janelia-experimental-technology/ElectricalPenetrationGraph/docs/model/preview.png

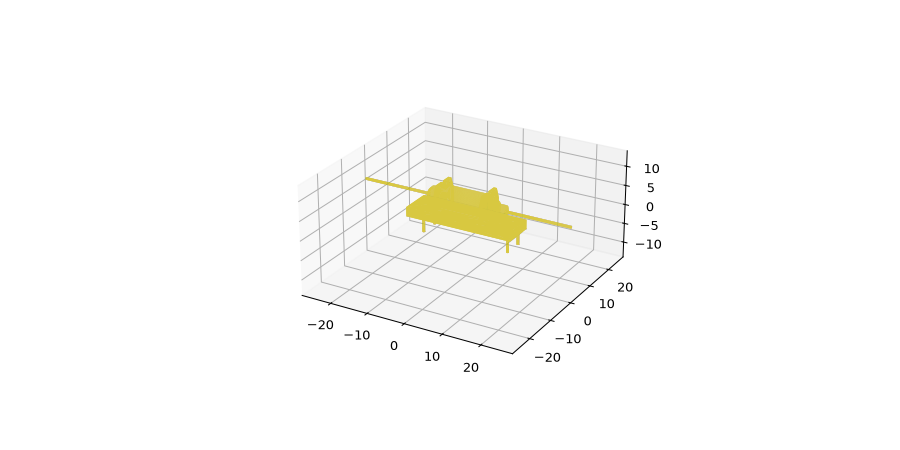
docs/model/preview.png
