janelia-experimental-technology/ElectricalPenetrationGraph/hardware/pcb/eagle/EPGcontrol.csv

Partlist exported from C:/Users/sawtelles/Documents/GitHub/ElectricalPenetrationGraph/hardware/pcb/eagle/EPGcontrol.sch at 11/9/2026 2:55 PM
Qty | Value | Device | Designators | Manufacturer | Man PN | Vendor | Vendor PN | $ea | $Total | Notes
1 |  | CONN_02LOCK | EARTH-GND
1 |  | CONN_03LOCK | J11
1 |  | CONN_04LOCK | GND
2 |  | DIODESMA | D1 D2
1 |  | PADPAD_040 | J1
1 |  | TPS723 | U2
3 | 0 | RESISTOR_SM0805S | R1 R2 R5
14 | 0.1 | CAPS0603S | C1 C3 C6 C7 C11 C12 C13 C27 C28 C31 C40 C41 C42 C59
12 | 1 | CAPS0805S | C25 C26 C32 C51 C52 C53 C54 C55 C56 C57 C58 C60
16 | 1K00 | RESISTOR_SM0805S | R14 R15 R16 R18 R24 R27 R28 R29 R30 R31 R32 R33 R35 R36 R37 R38
1 | 1K02 | RESISTOR_SM0805S | R34
8 | 2K00 | RESISTOR_SM0805S | R7 R8 R9 R10 R22 R23 R25 R26
8 | 4.7n | CAPS0805S | C43 C44 C45 C46 C47 C48 C49 C50
7 | 10 | C-EUC1206 | C2 C4 C5 C8 C9 C14 C15
16 | 10 | CAPS1206S | C16 C17 C18 C19 C20 C21 C22 C23 C29 C33 C34 C35 C36 C37 C38 C39
9 | 49K9 | RESISTOR_SM0805S | R6 R11 R12 R13 R17 R19 R20 R21 R39
16 | 49R9 | RESISTOR_SM0805S | R40 R41 R42 R43 R44 R45 R46 R47 R48 R49 R50 R51 R52 R53 R54 R55
8 | 54-00248 | 54-00248 | J2 J3 J4 J5 J6 J7 J8 J9
1 | 150n | CAPS0603S | C30
1 | 220n | CAPS0603S | C24
8 | 600mA/40V | TRANS_NPN-MMBT2222AL | Q1 Q2 Q3 Q4 Q5 Q6 Q7 Q8
1 | ADS131M08QPBSRQ1 | ADS131M08QPBSRQ1 | U3
1 | DAC8568IBPW | DAC8568IBPW | U5
2 | FERRITE BEAD | INDUCTOR_SM0805S | L1 L2
1 | LP2988AIM-5.0 | LP2988AIM-5.0 | U1
1 | MIC5219 3.3V | V_REG_MIC52193.3V | LP5907
1 | NMH0509DC | DC-DC-PDS1-DUALPDM2 | PS1
1 | OPA344 | OPA344 | U7
2 | QUAD_OPAMPD | QUAD_OPAMPD | U4 U6
1 | RASPBERRY-PI-PICO_TH | RASPBERRY-PI-PICO_TH | U$1
