janelia-experimental-technology/ElectricalPenetrationGraph/hardware/pcb/eagle/EPGcontrol.xlsx

Partlist exported from C:/Users/sawtelles/Documents/GitHub/ElectricalPenetrationGraph/hardware/pcb/eagle/EPGcontrol.sch at 11/9/2026 2:55 PM
Qty | Value | Device | Designators | Manufacturer | Man PN | Vendor | Vendor PN | $ea | $Total | Notes
1 |  | CONN_02LOCK | EARTH-GND
1 |  | CONN_03LOCK | J11
1 |  | CONN_04LOCK | GND
2 |  | DIODESMA | D1 D2 | Microsemi | LSM115JE3/TR13 | DK | LSM115JE3/TR13CT-ND (https://www.digikey.com/product-detail/en/microsemi-corporation/LSM115JE3-TR13/LSM115JE3-TR13CT-ND/1634547)
1 |  | PADPAD_040 | J1
1 | -5V LDO | IC REG LIN -5V 200MA TSOT-23-5 | U2 | Analog Devices Inc. | ADP7182AUJZ-5.0-R7 |  | 505-ADP7182AUJZ-5.0-R7CT-ND | $5.67
3 | 0 | RESISTOR_SM0805S | R1 R2 R5
14 | 0.1 | CAPS0603S | C1 C3 C6 C7 C11 C12 C13 C27 C28 C31 C40 C41 C42 C59
12 | 1 | CAPS0805S | C25 C26 C32 C51 C52 C53 C54 C55 C56 C57 C58 C60
16 | 1K00 | RESISTOR_SM0805S | R14 R15 R16 R18 R24 R27 R28 R29 R30 R31 R32 R33 R35 R36 R37 R38
1 | 1K02 | RESISTOR_SM0805S | R34
8 | 2K00 | RESISTOR_SM0805S | R7 R8 R9 R10 R22 R23 R25 R26
8 | 4.7n | CAPS0805S | C43 C44 C45 C46 C47 C48 C49 C50
23 | 10 | CAPS1206S | C2 C4 C5 C8 C9 C14 C15 C16 C17 C18 C19 C20 C21 C22 C23 C29 C33 C34 C35 C36 C37 C38 C39
9 | 49K9 | RESISTOR_SM0805S | R6 R11 R12 R13 R17 R19 R20 R21 R39
16 | 49R9 | RESISTOR_SM0805S | R40 R41 R42 R43 R44 R45 R46 R47 R48 R49 R50 R51 R52 R53 R54 R55
8 | 54-00248 | CONN RCPT FMALE 8POS GOLD SOLDER | J2 J3 J4 J5 J6 J7 J8 J9 | Tensility | 54-00248 |  | 839-54-00248-ND | $8.85
1 | 150n | CAPS0603S | C30
1 | 220n | CAPS0603S | C24
8 | 600mA/40V | TRANS_NPN-TRANS NPN 40V 0.6A SOT23-3 | Q1 Q2 Q3 Q4 Q5 Q6 Q7 Q8 | onsemi | MMBT2222ALT1G |  | MMBT2222ALT1GOSCT-ND | $0.15
1 | IC ADC 24BIT 32-TQFP | ADS131M08QPBSRQ1 | U3 | Texas Instruments | ADS131M08QPBSRQ1 |  | 296-ADS131M08QPBSRQ1CT-ND | $14.19
1 | IC DAC 16BIT 16-TSSOP | DAC8568IBPW | U5 | Texas Instruments | DAC8568IBPW |  | 296-24445-5-ND | $30.32
2 | FERRITE BEAD | INDUCTOR_SM0805S | L1 L2 | Laird | MI0805J102R-10 | DK | 240-2551-1-ND | $0.18
1 | LP2988AIM-5.0 | IC REG LINEAR 5V 200MA 8-SOIC | U1 | Texas Instruments | LP2988AIM-5.0/NOPB |  | LP2988AIM-5.0/NOPB-ND | $3.93
1 | MIC5219 3.3V | IC REG LINEAR 3.3V 500MA SOT23-5 | LP5907 | Microchip Technology | MIC5219-3.3YM5-TR |  | 576-1281-1-ND | $1.19
1 | NMH0509DC | DC-DC-PDS1-DUALPDM2 | PS1 | Murata | NMH0509DC | DK | 811-1506-5-ND | $13.20
1 | LTC2054 | IC OP AMP 1CH TSOT-23-5 | U7 | Analog Devices Inc. | LTC2054HVCS5#TRMPBF |  | LTC2054HVCS5#TRMPBFCT-ND | $5.25
2 | QUAD_OPAMPD | IC OP AMP 4CH 14-SOIC | U4 U6 | Texas Instruments | TLC2254IDR | DK | 296-1301-1-ND | $2.76
1 | RASPBERRY PI PICO H RP2040 | RASPBERRY-PI-PICO_TH | U$1 | Raspberry Pi | SC0917 |  | 2648-SC0917-ND | $5.00
