janelia-experimental-technology/ElectricalPenetrationGraph/docs/1U-side-extrusion.dxf

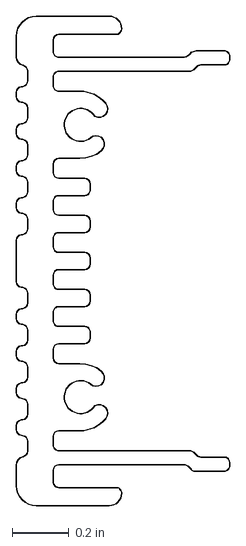
[picture p2: CAD file, 2026-11-13]
docs/1U-side-extrusion.dxf
0.75 x 1.72 in
