janelia-experimental-technology/ElectricalPenetrationGraph/docs/model/MRE05-1A79-BV384.step

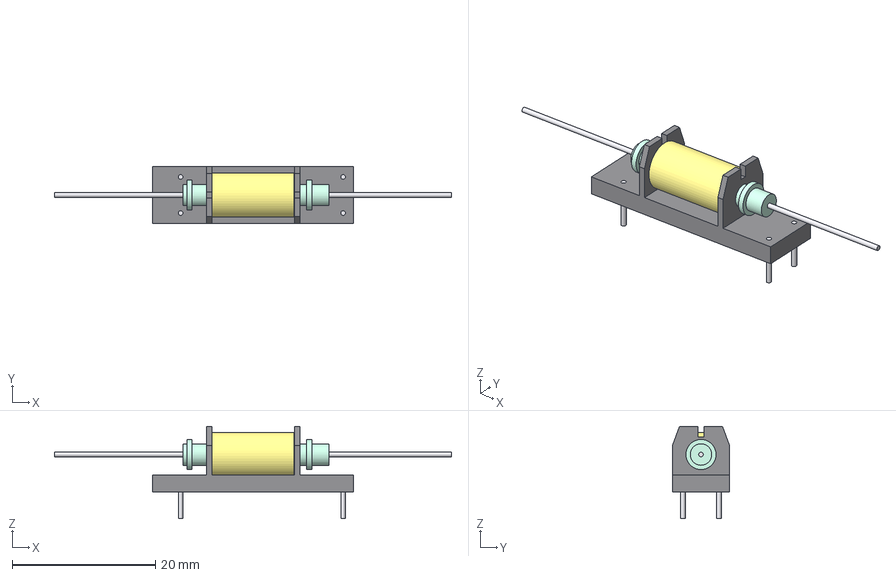
[picture p3: CAD file, 2026-10-17]
docs/model/MRE05-1A79-BV384.step
55.4 x 8.00 x 12.9 mm
holder
glass
leads
pins
