janelia-experimental-technology/ElectricalPenetrationGraph/hardware/1Uside3D.stp

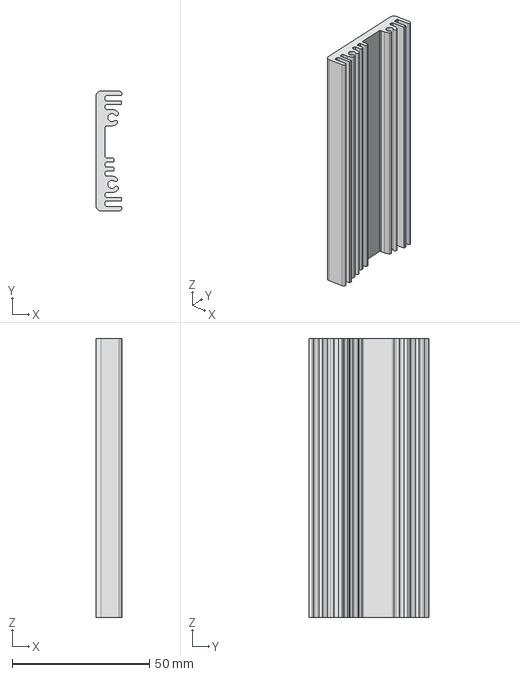
[picture p4: CAD file, 2026-11-13]
hardware/1Uside3D.stp
9.40 x 43.7 x 101.6 mm
