janelia-experimental-technology/ElectricalPenetrationGraph/hardware/pcb/eagle/1550A/1550A/1550A.dxf

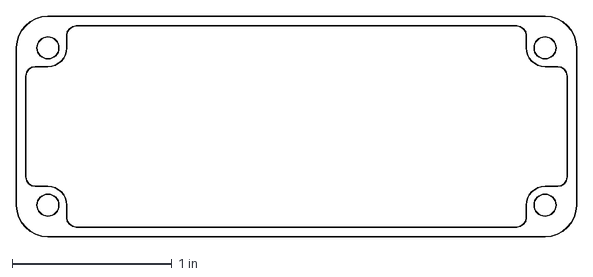
[picture p5: CAD file, 2026-10-17]
hardware/pcb/eagle/1550A/1550A/1550A.dxf
3.50 x 1.38 in
