janelia-experimental-technology/ElectricalPenetrationGraph/hardware/pcb/eagle/1UsideCNC.dxf

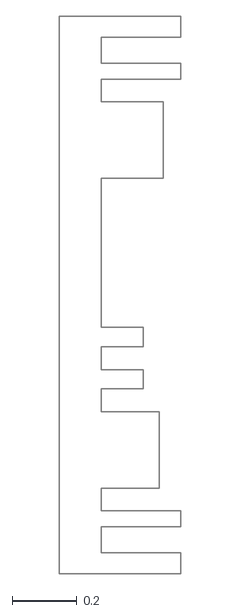
[picture p6: CAD file, 2026-11-13]
hardware/pcb/eagle/1UsideCNC.dxf
0.375 x 1.72
