janelia-experimental-technology/ElectricalPenetrationGraph/docs/Side Profile 10x42_G122010 10x42mm.dxf

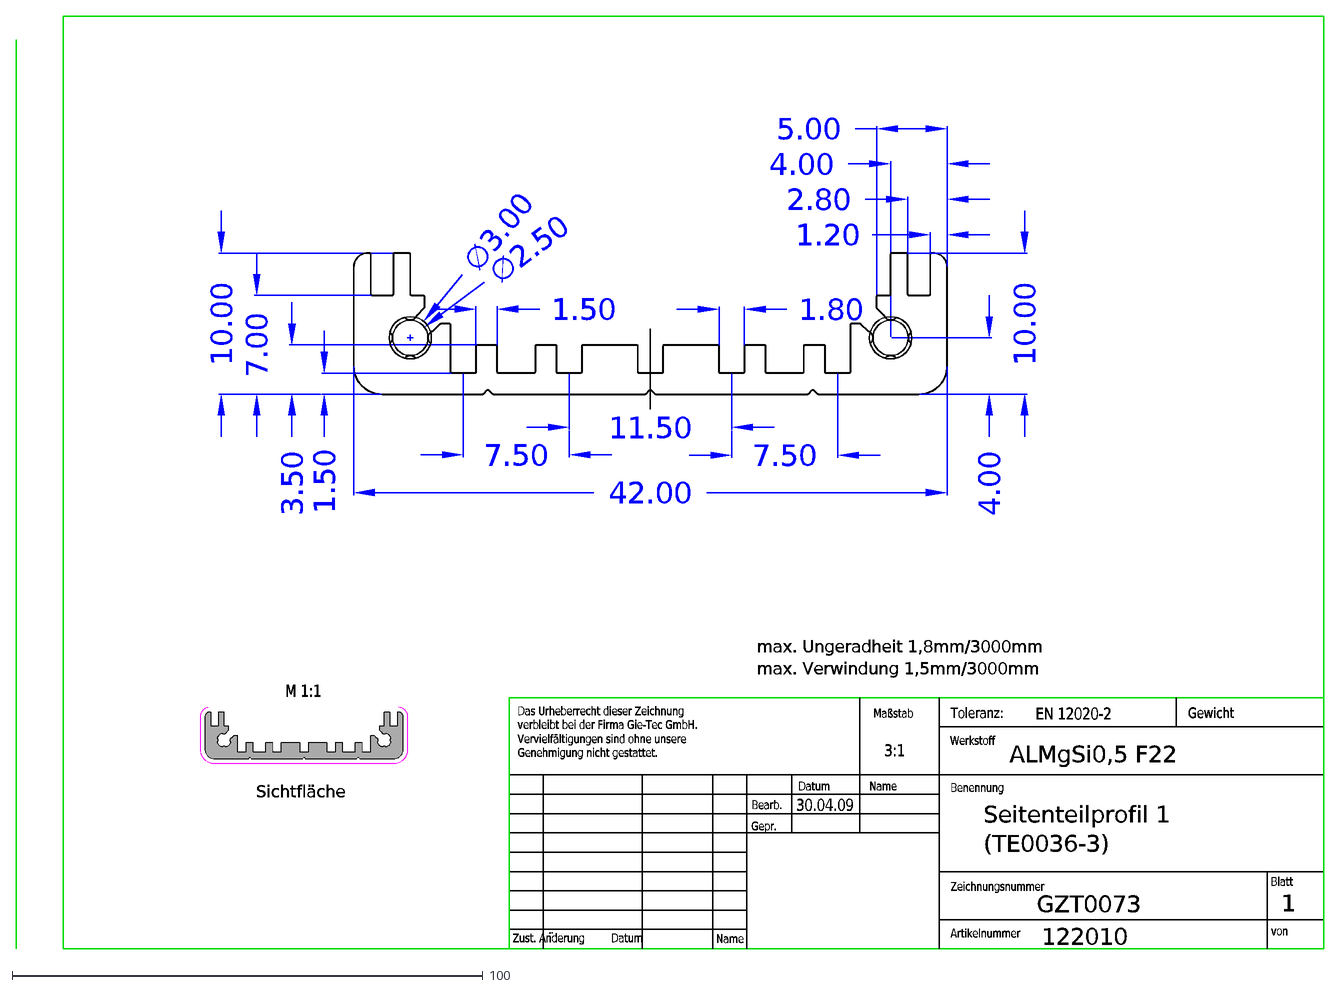
[picture p7: CAD file, 2026-11-13]
docs/Side Profile 10x42_G122010 10x42mm.dxf
Toleranz:
Benennung
ALMgSi0,5 F22
Seitenteilprofil 1
Artikelnummer
Zeichnungsnummer
Zust. Anderung Datum
Gepr.
Bearb.
Name
Datum
30.04.09
Maßstab
Werkstoff
GZT0073
1
von
Blatt
EN 12020-2
Gewicht
3:1
max. Ungeradheit 1,8mm/3000mm
Das Urheberrecht dieser Zeichnung
verbleibt bei der Firma Gie-Tec GmbH.
Vervielfältigungen sind ohne unsere
Genehmigung nicht gestattet.
122010
(TE0036-3)
M 1:1
Sichtfläche
max. Verwindung 1,5mm/3000mm
10.00
∅3.00
5.00
4.00
2.80
1.20
42.00
3.50
1.50
7.50
11.50
∅2.50
7.00
1.80
