janelia-experimental-technology/ElectricalPenetrationGraph/hardware/1UsideCNC.stp

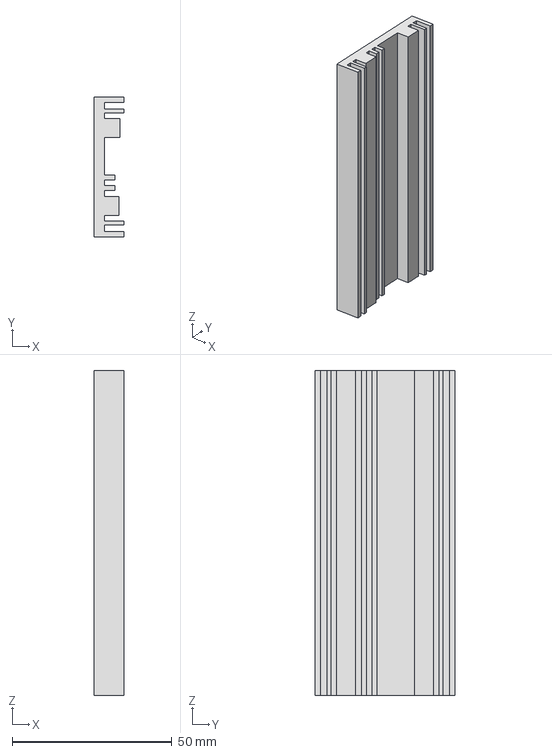
[picture p8: CAD file, 2026-11-13]
hardware/1UsideCNC.stp
9.52 x 43.7 x 101.6 mm
