janelia-experimental-technology/ElectricalPenetrationGraph/hardware/pcb/eagle/1550A.stp

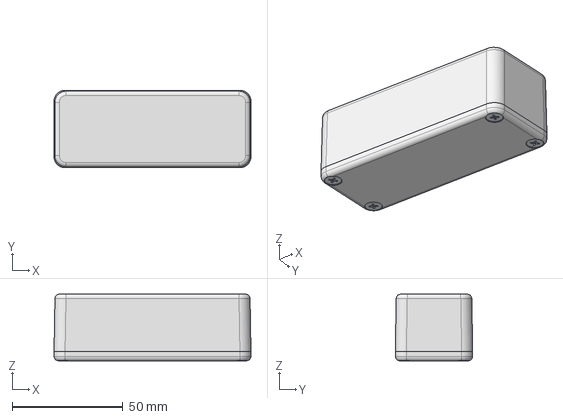
[picture p9: CAD file, 2026-10-17]
hardware/pcb/eagle/1550A.stp
89.0 x 35.0 x 30.1 mm
