janelia-experimental-technology/ElectricalPenetrationGraph/hardware/pcb/eagle/pomona_2397_box_no_cover.step

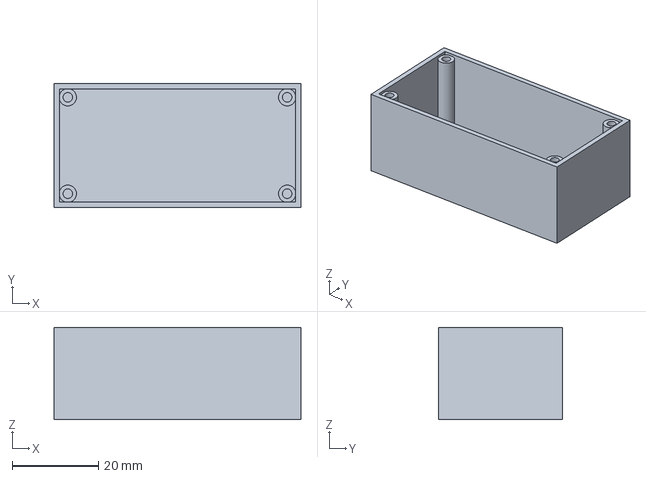
[picture p10: CAD file, 2026-10-07]
hardware/pcb/eagle/pomona_2397_box_no_cover.step
57.1 x 28.7 x 21.3 mm
