janelia-experimental-technology/ElectricalPenetrationGraph/docs/1U-side-extrusion-mk-9.step

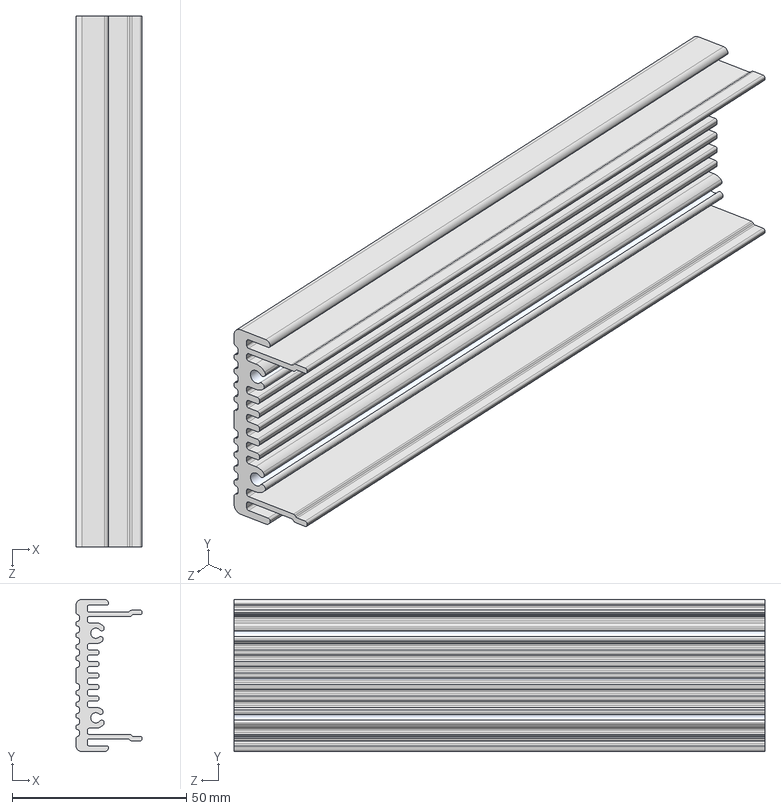
[picture p11: CAD file, 2026-11-09]
docs/1U-side-extrusion-mk-9.step
19.0 x 43.7 x 152.4 mm
