janelia-experimental-technology/ElectricalPenetrationGraph/hardware/pcb/eagle/54-00248(2).STEP

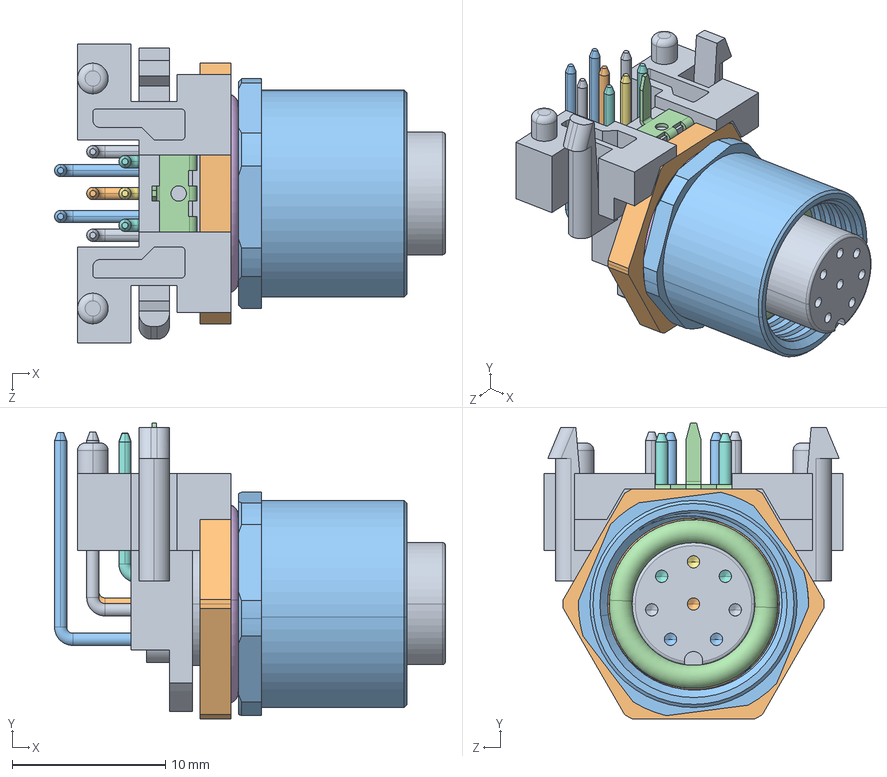
[picture p12: CAD file, 2026-09-30]
hardware/pcb/eagle/54-00248(2).STEP
25.5 x 19.3 x 19.5 mm
