janelia-experimental-technology/ElectricalPenetrationGraph/hardware/pcb/eagle/BJ21.stp

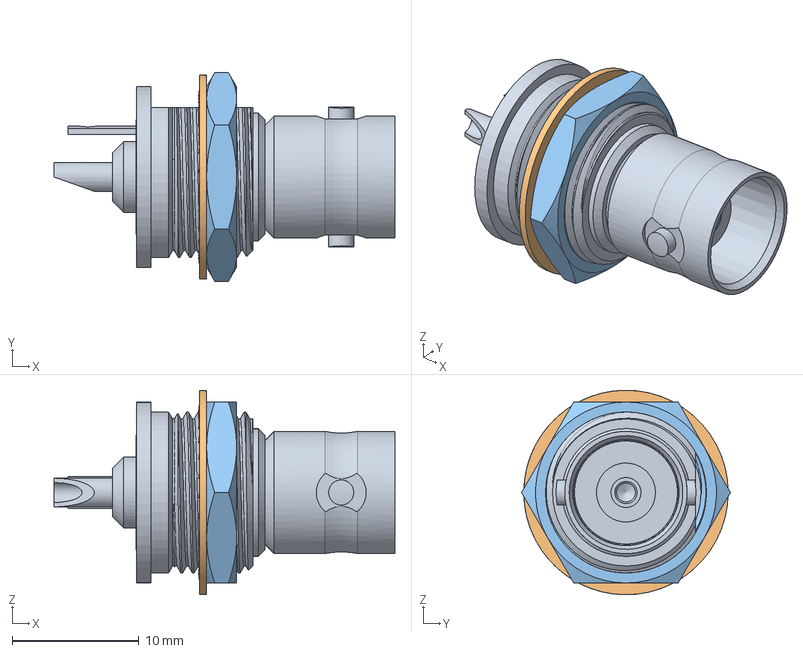
[picture p13: CAD file, 2026-09-30]
hardware/pcb/eagle/BJ21.stp
26.9 x 16.5 x 16.1 mm
BJ21_PART1
BJ21_PART2
BJ21_PART3
