janelia-experimental-technology/ElectricalPenetrationGraph/(list of files, cad)

Other CAD files:
docs/1u-ext.dwg
docs/1U-side-extrusion-mk-9.dxf
docs/1U-side-extrusion-mk-9/1U-side-extrusion-mk-9/1U-side-extrusion-mk-9.ipt
docs/model/MRE05-1A79-BV384.stl
docs/model/MRE05-1A79-BV384/MRE05-1A79-BV384/MRE05-1A79-BV384.iam
docs/model/MRE05-1A79-BV384/MRE05-1A79-BV384/OldVersions/MRE05-1A79-BV384.0001.iam
docs/model/MRE05-1A79-BV384/MRE05-1A79-BV384/OldVersions/body.0001.ipt
docs/model/MRE05-1A79-BV384/MRE05-1A79-BV384/OldVersions/glass.0001.ipt
docs/model/MRE05-1A79-BV384/MRE05-1A79-BV384/OldVersions/holder.0001.ipt
docs/model/MRE05-1A79-BV384/MRE05-1A79-BV384/OldVersions/leads.0001.ipt
docs/model/MRE05-1A79-BV384/MRE05-1A79-BV384/OldVersions/pins.0001.ipt
docs/model/MRE05-1A79-BV384/MRE05-1A79-BV384/body.ipt
docs/model/MRE05-1A79-BV384/MRE05-1A79-BV384/glass.ipt
docs/model/MRE05-1A79-BV384/MRE05-1A79-BV384/holder.ipt
docs/model/MRE05-1A79-BV384/MRE05-1A79-BV384/leads.ipt
docs/model/MRE05-1A79-BV384/MRE05-1A79-BV384/pins.ipt
hardware/1Uside3D.ipt
hardware/1UsideCNC.ipt
hardware/3dext.ipt
hardware/OldVersions/1UsideCNC.0001.ipt
hardware/OldVersions/3dext.0001.ipt
hardware/OldVersions/cncext.0001.ipt
hardware/cncext.ipt
hardware/pcb/eagle/1550A.igs
hardware/pcb/eagle/1550A/1550A/1550A BOX v11.ipt
hardware/pcb/eagle/1550A/1550A/1550A LID v11.ipt
hardware/pcb/eagle/1550A/1550A/1550A.iam
hardware/pcb/eagle/1550A/1550A/OldVersions/1550A BOX v11.0002.ipt
hardware/pcb/eagle/1550A/1550A/SC1550 (screw M3.5-0.6X 12mm FH).ipt
hardware/pcb/eagle/AIS2024/BJ21.iam
hardware/pcb/eagle/AIS2024/BJ21_PART1.ipt
hardware/pcb/eagle/AIS2024/BJ21_PART2.ipt
hardware/pcb/eagle/AIS2024/BJ21_PART3.ipt
hardware/pcb/eagle/AIS2024/OldVersions/BJ21_PART1.0001.ipt
hardware/pcb/eagle/AIS2024/OldVersions/BJ21_PART3.0001.ipt
hardware/pcb/eagle/OldVersions/epgIn.0004.iam
hardware/pcb/eagle/OldVersions/epgrelay.0003.iam
hardware/pcb/eagle/OldVersions/epgrelay.0004.iam
hardware/pcb/eagle/OldVersions/pcb.0002.ipt
hardware/pcb/eagle/epgIn.iam
hardware/pcb/eagle/epgrelay.iam
hardware/pcb/eagle/pcb.ipt
hardware/pcb/eagle/pomona_2397_box_no_cover/pomona_2397_box_no_cover/OldVersions/pomona_2397_box_no_cover.0001.ipt
hardware/pcb/eagle/pomona_2397_box_no_cover/pomona_2397_box_no_cover/pomona_2397_box_no_cover.ipt
