janelia-experimental-technology/ElectricalPenetrationGraph/docs/Giga_rig_manuals/Installation Guide Giga-8dd.pdf

2026-02-27

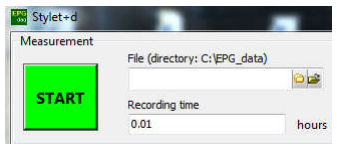
[picture p37: figure]

Note: In case of any installation or other questions / problems, please contact info@epgsystems.eu

## -- Installation Guide 2025 –

### Combined Stylet+ software, and Giga-8dd hardware installation

Read this guide first completely and then follow the instruction step by step.

1. The Stylet+_setup 25 (styletaq v01.34.exe) file should be downloaded and opened on your computer
https://epgsystems.eu/downloads-install-files-manuals/category/3-installation

NOTE: your organization may block downloading .exe files from the internet. Ask your system administrator for permission to do so.

2. Click on ´continue´ messages, accept copyright, etc. and next, subtract the FTDI CMD Drivers. You will end up in the demo screen for data acquisition. As indicated in the bottom right corner by ‘Demo device’
3. You may either close or continue this demo data acquisition session (see Giga-8dd manual).
4. Your C:\Stylet+ folder should now at least contain the Stylet+a.exe, Stylet+d.exe and unins000.exe files (the older* Giga-8d device requires to download and use Stylet+d_V01.30.exe for data acquisition).

For Giga-8dd operation (EPG recording) download and read Manual-Giga-8dd 20-03-2025.pdf
