janelia-experimental-technology/ElectricalPenetrationGraph/docs/extrusion-dimensions.pdf

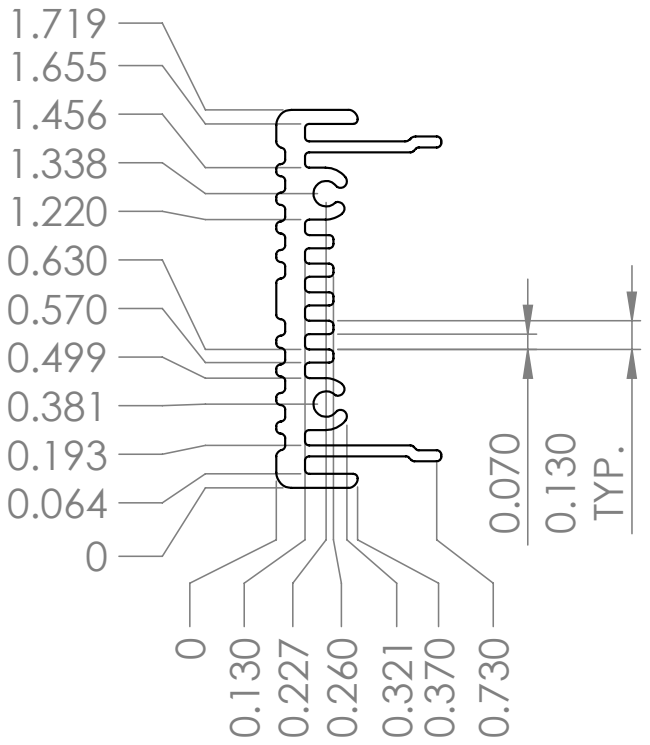
[picture p38: page 1]
