janelia-experimental-technology/ElectricalPenetrationGraph/docs/Giga_rig_manuals/aphid waveform characteristics.pdf

# Aphid waveform characteristics

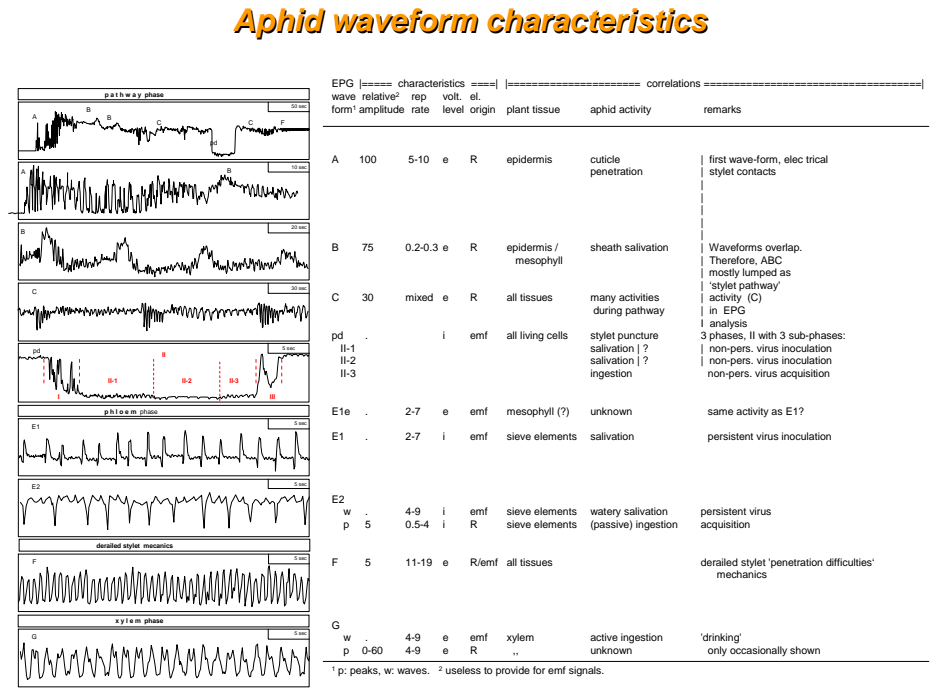
[picture p39: page 1]
50 sec; p a t h w a y phase; 10 sec; 20 sec; 30 sec; 5 sec; x y l e m phase; 5 sec F; p h l o e m phase; 5 sec pd; III; wave relative² rep; volt. el.; form¹ amplitude rate level origin plant tissue; aphid activity; remarks; epidermis; cuticle; | first wave-form, elec trical; penetration; | stylet contacts; epidermis /; sheath salivation; | Waveforms overlap.; mesophyll; | Therefore, ABC; mixed e; all tissues; many activities; | activity (C); during pathway; | in EPG; I analysis; emf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

EPG |======characteristics=====|--|=======================correlations ====================================

mostly lumped as
‘stylet pathway’

derailed stylet mecanics

1 p: peaks, w: waves. 2 useless to provide for emf signals.
