janelia-experimental-technology/ElectricalPenetrationGraph/Sims/relayDrive.asc

C1: cap; 10µ
L1: ind; 1m; Rser=250
R1: res; 1000
V1: voltage; 5; Rser=0
Named nets: 0
.tran 0 .01 0 .001 startup
