janelia-experimental-technology/ElectricalPenetrationGraph/hardware/pcb/single_channel_1G/single_channel_1G.kicad_pcb

## KiCad design hardware/pcb/single_channel_1G/single_channel_1G.kicad_pcb (2026-09-24)

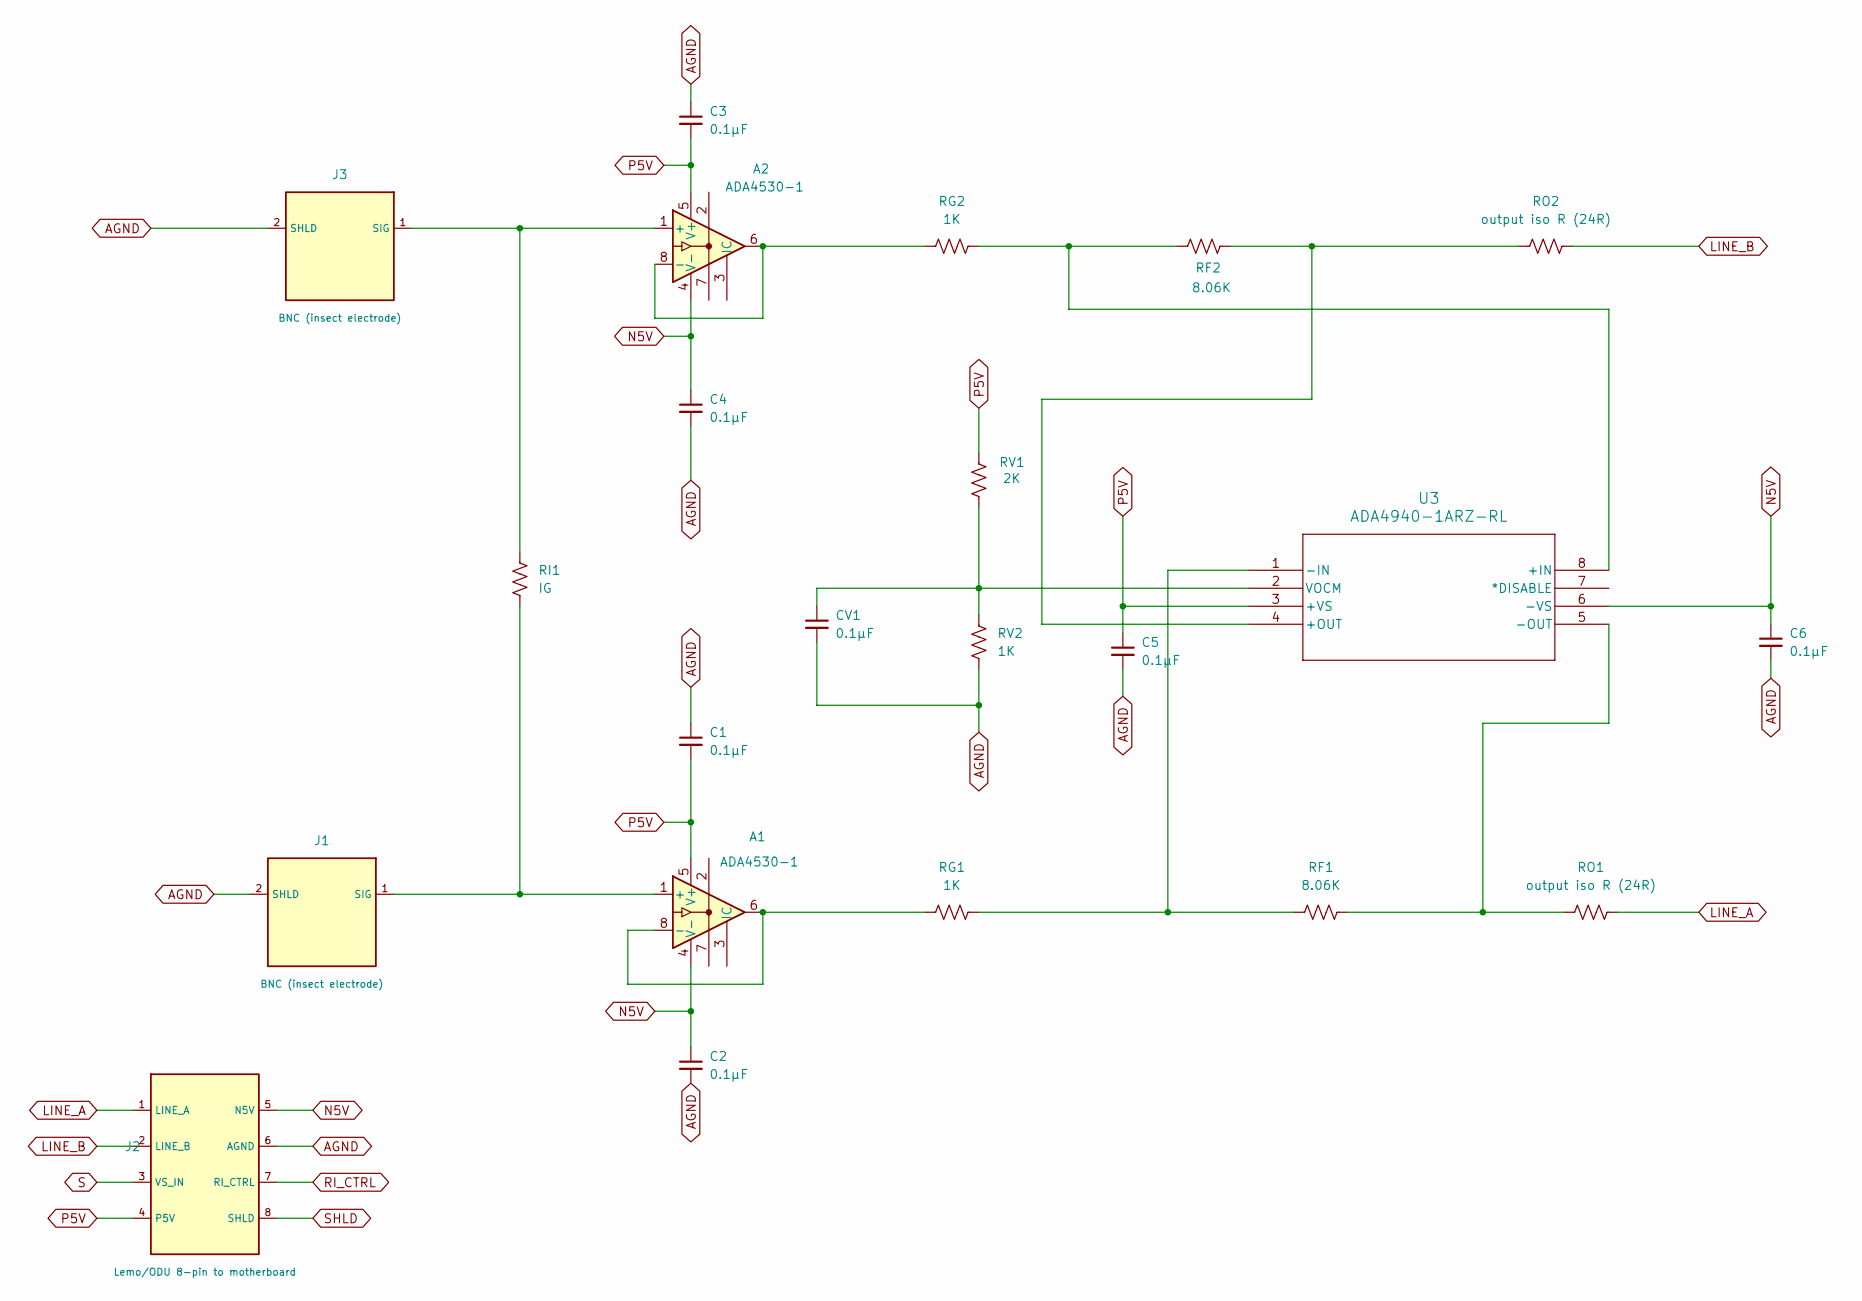
[picture p40: schematic single_channel_1G.kicad_sch]

Parts:
A1, A2: ADA4530-1; SOIC-8_3.9x4.9mm_P1.27mm
C1, C2, C3, C4, C5, C6: 0.1µF; C_0603_1608Metric
CV1: 0.1µF; C_0603_1608Metric
J1, J3: BNC (insect electrode); BNC_Amphenol_031-5539_Vertical
J2: Lemo/ODU 8-pin to motherboard; PinHeader_1x08_P2.54mm_Vertical
RF1, RF2: 8.06K; R_0805_2012Metric
RG1, RG2: 1K; R_0805_2012Metric
RI1: IG; R_Axial_DIN0309_L9.0mm_D3.2mm_P20.32mm_Horizontal
RO1, RO2: output iso R (24R); R_0603_1608Metric
RV1: 2K; R_0805_2012Metric
RV2: 1K; R_0805_2012Metric
U3: ADA4940-1ARZ-RL; SOIC-8_5.3x6.2mm_P1.27mm

Connections:
AGND: C1.1, C2.2, C3.1, C4.2, C5.2, C6.2, CV1.2, J1.2 (SHLD), J2.6 (AGND), J3.2 (SHLD), RV2.2
LINE_A: J2.1 (LINE_A), RO1.1
LINE_B: J2.2 (LINE_B), RO2.1
N5V: A1.4 (V-), A2.4 (V-), C2.1, C4.1, C6.1, J2.5 (N5V), U3.6 (-VS)
unnamed: A1.1 (+), J1.1 (SIG), RI1.2
unnamed: A1.6, A1.8 (-), RG1.2
unnamed: A2.1 (+), J3.1 (SIG), RI1.1
unnamed: A2.6, A2.8 (-), RG2.2
unnamed: RF2.2, RG2.1, U3.8 (+IN)
unnamed: RF2.1, RO2.2, U3.4 (+OUT)
unnamed: RF1.2, RG1.1, U3.1 (-IN)
unnamed: RF1.1, RO1.2, U3.5 (-OUT)
unnamed: CV1.1, RV1.2, RV2.1, U3.2 (VOCM)
P5V: A1.5 (V+), A2.5 (V+), C1.2, C3.2, C5.1, J2.4 (P5V), RV1.1, U3.3 (+VS)
RI_CTRL: J2.7 (RI_CTRL)
S: J2.3 (VS_IN)
SHLD: J2.8 (SHLD)

Board: 2 copper layers, 22 parts (0 on the bottom side), 14 nets, no tracks yet.
