janelia-experimental-technology/ElectricalPenetrationGraph/hardware/pcb/eagle/EPGcontrolA.brd

## EAGLE design hardware/pcb/eagle/EPGcontrolA.brd (2026-11-13)

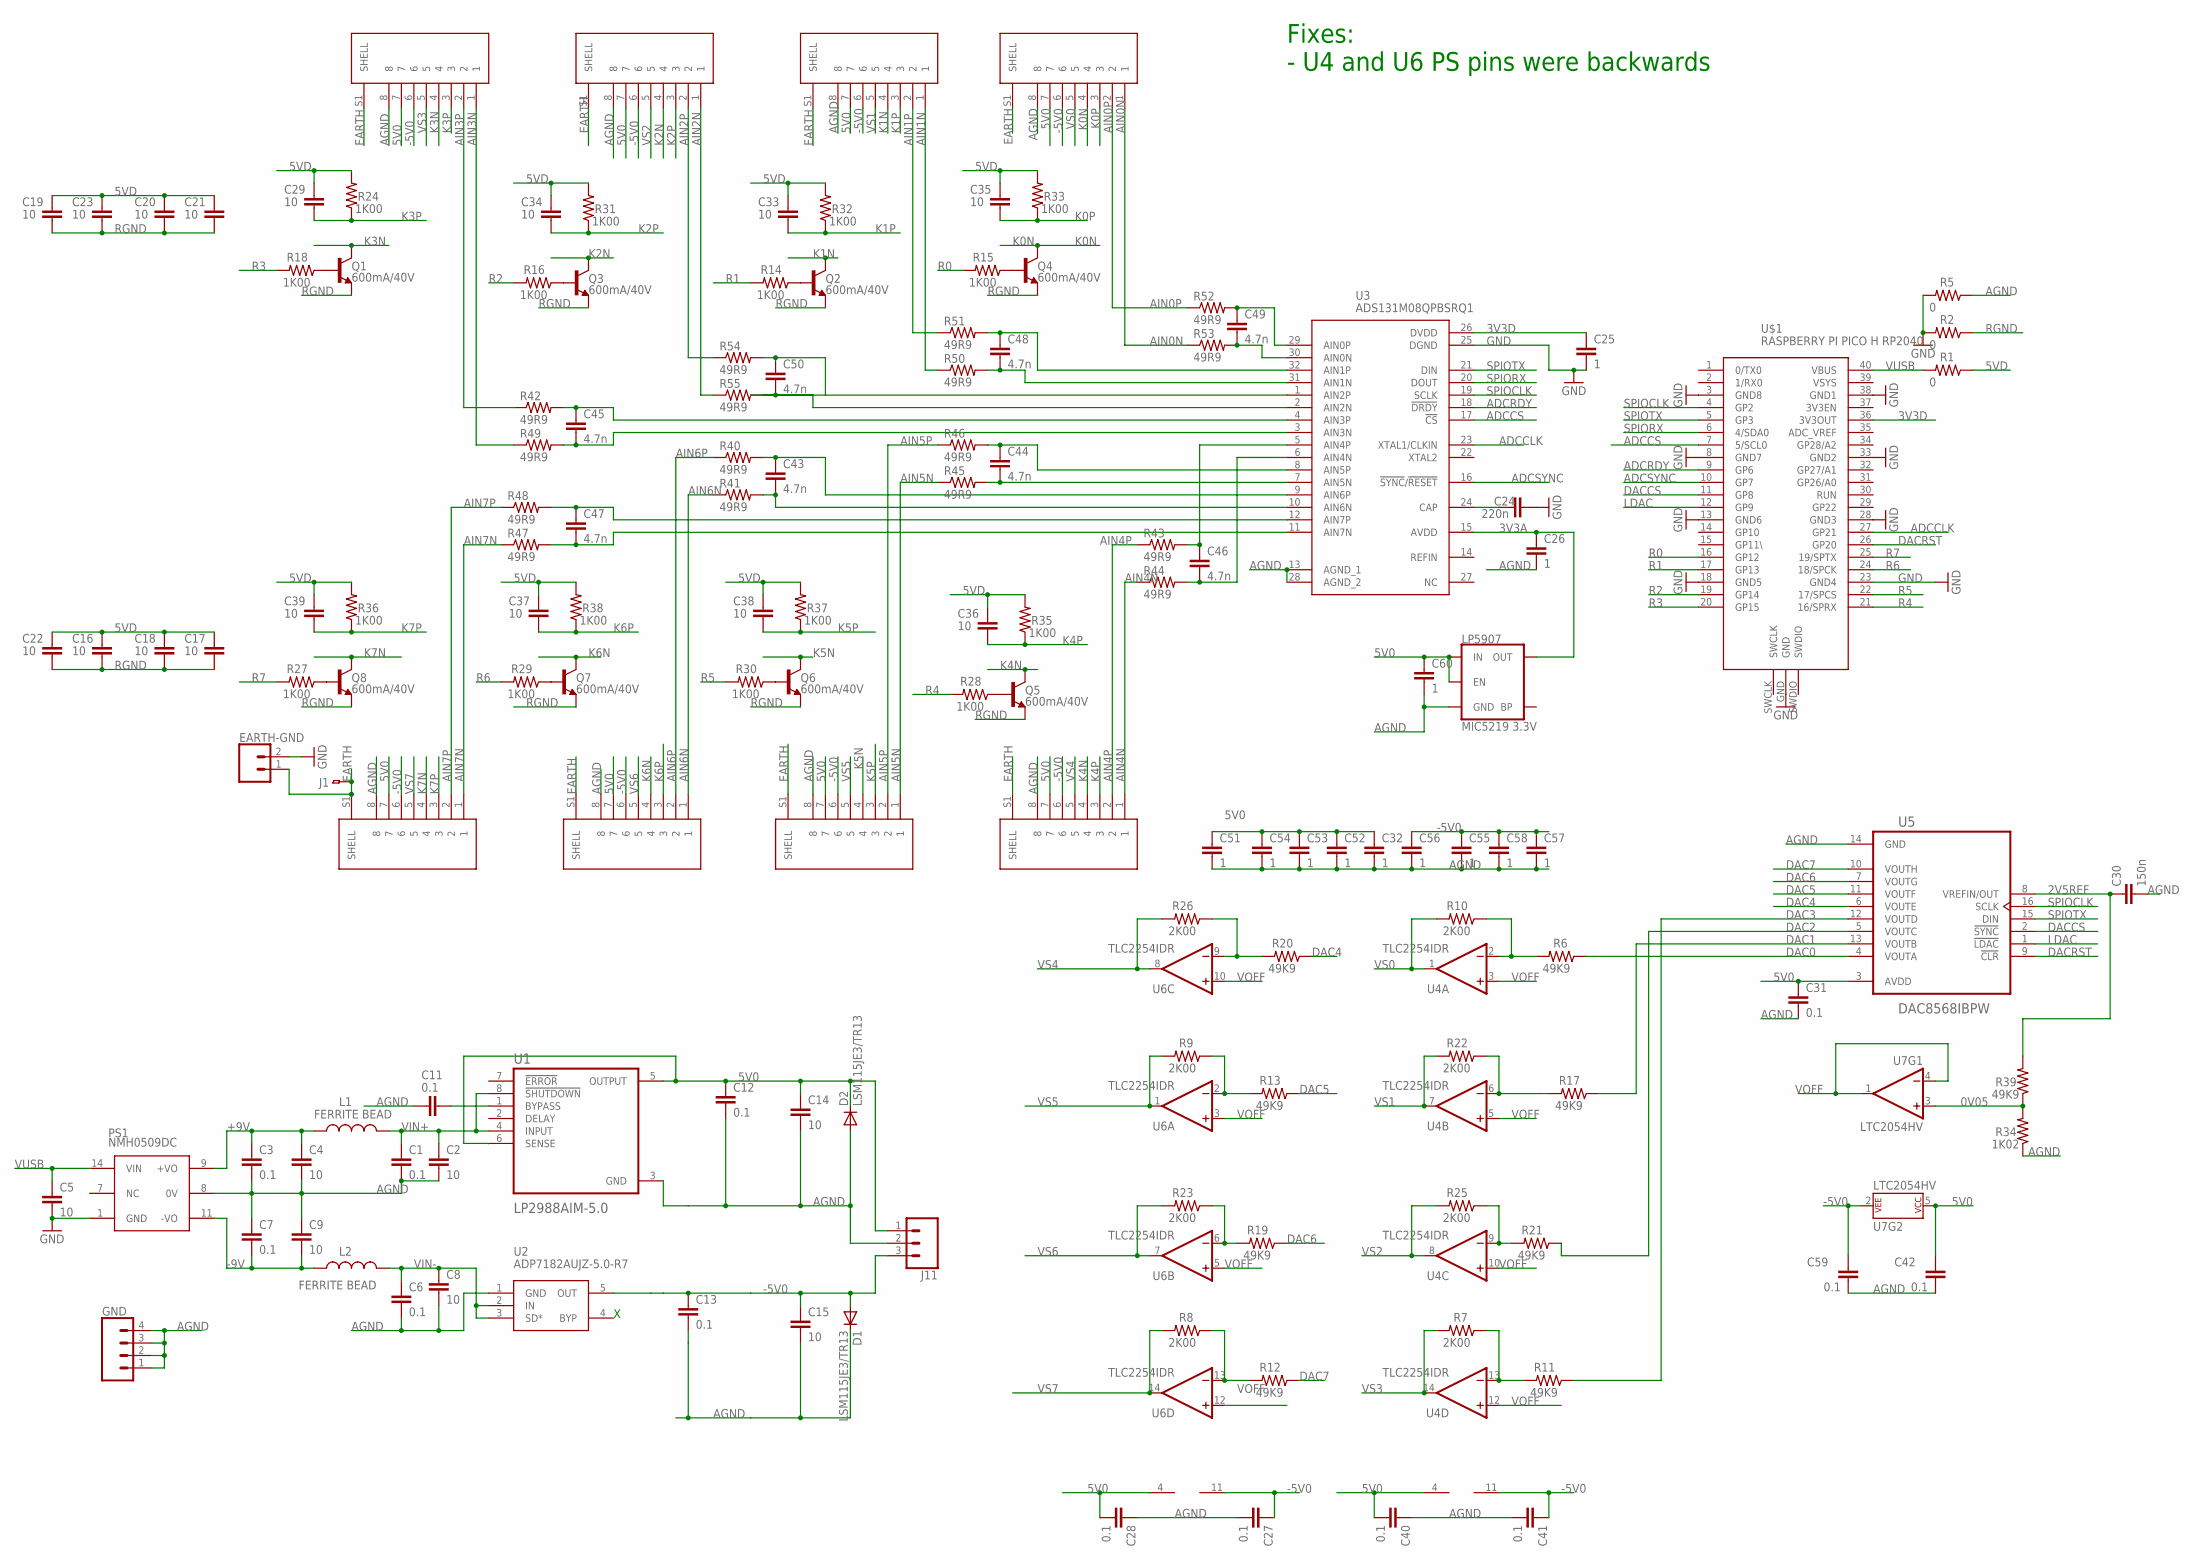
[picture p41: schematic EPGcontrolA.sch]

Parts:
C1, C3, C6, C7, C11, C12, C13, C27, C28, C31, C40, C41, C42, C59: 0.1; 0603S
C2, C4, C5, C8, C9, C14, C15: 10; C1206
C16, C17, C18, C19, C20, C21, C22, C23, C29, C33, C34, C35, C36, C37, C38, C39: 10; 1206S
C24: 220n; 0603S
C25, C26, C32, C51, C52, C53, C54, C55, C56, C57, C58, C60: 1; 0805S
C30: 150n; 0603S
C43, C44, C45, C46, C47, C48, C49, C50: 4.7n; 0805S
D1, D2: LSM115JE3/TR13; SMA-DIODE
EARTH-GND: CONN_02LOCK; 1X02_LOCK
GND: CONN_04LOCK; 1X04_LOCK
J1: PADPAD_040; PAD_040
J2, J3, J4, J5, J6, J7, J8, J9: 54-00248; TENSILITY_54-00248
J11: CONN_03LOCK; 1X03_LOCK
L1, L2: FERRITE BEAD; 0805S
LP5907: MIC5219 3.3V; SOT23-5
PS1: NMH0509DC; PDM2
Q1, Q2, Q3, Q4, Q5, Q6, Q7, Q8: 600mA/40V; SOT23-3
R1, R2, R5: 0; 0805S
R6, R11, R12, R13, R17, R19, R20, R21, R39: 49K9; 0805S
R7, R8, R9, R10, R22, R23, R25, R26: 2K00; 0805S
R14, R15, R16, R18, R24, R27, R28, R29, R30, R31, R32, R33, R35, R36, R37, R38: 1K00; 0805S
R34: 1K02; 0805S
R40, R41, R42, R43, R44, R45, R46, R47, R48, R49, R50, R51, R52, R53, R54, R55: 49R9; 0805S
U1: LP2988AIM-5.0; SOIC127P599X175-8N
U2: ADP7182AUJZ-5.0-R7; SOT23-5
U3: ADS131M08QPBSRQ1; QFP50P700X700X120-32N
U4, U6: TLC2254IDR; SO14
U5: DAC8568IBPW; SOP65P640X120-16N
U7: LTC2054HV; SOT23-5
U$1: RASPBERRY PI PICO H RP2040; FT_RASPBERRY-PI-PICO_TH

Connections:
0V05: R34.2, R39.1, U7.3 (+IN)
2V5REF: C30.1, R39.2, U5.8 (VREFIN/OUT)
3V3A: C26.1, LP5907.5 (OUT), U3.15 (AVDD)
3V3D: C25.1, U3.26 (DVDD), U$1.36 (3V3OUT)
5V0: C12.1, C14.1, C28.2, C31.1, C32.1, C40.2, C42.1, C51.1, C52.1, C53.1, C54.1, C60.1, D2.C, J2.7, J3.7, J4.7, J5.7, J6.7, J7.7, J8.7, J9.7, J11.1, LP5907.1 (IN), LP5907.3 (EN), U1.5 (OUTPUT), U1.6 (SENSE), U4.4 (V+), U5.3 (AVDD), U6.4 (V+), U7.5 (P$V+)
5VD: C16.1, C17.1, C18.1, C19.1, C20.1, C21.1, C22.1, C23.1, C29.1, C33.1, C34.1, C35.1, C36.1, C37.1, C38.1, C39.1, R1.1, R24.2, R31.2, R32.2, R33.2, R35.2, R36.2, R37.2, R38.2
+9V: C3.1, C4.1, L1.1, PS1.9 (+VO)
-5V0: C13.1, C15.1, C27.1, C41.1, C55.1, C56.1, C57.1, C58.1, C59.1, D1.A, J2.6, J3.6, J4.6, J5.6, J6.6, J7.6, J8.6, J9.6, J11.3, U2.5 (OUT), U4.11 (V-), U6.11 (V-), U7.2 (P$V-)
-9V: C7.2, C9.2, L2.1, PS1.11 (-VO)
A0N: C49.2, R53.2, U3.30 (AIN0N)
A0P: C49.1, R52.2, U3.29 (AIN0P)
A1N: C48.2, R50.2, U3.31 (AIN1N)
A1P: C48.1, R51.2, U3.32 (AIN1P)
A2N: C50.2, R55.2, U3.2 (AIN2N)
A2P: C50.1, R54.2, U3.1 (AIN2P)
A3N: C45.2, R49.2, U3.3 (AIN3N)
A3P: C45.1, R42.2, U3.4 (AIN3P)
A4N: C46.2, R44.2, U3.6 (AIN4N)
A4P: C46.1, R43.2, U3.5 (AIN4P)
A5N: C44.2, R45.2, U3.7 (AIN5N)
A5P: C44.1, R46.2, U3.8 (AIN5P)
A6N: C43.2, R41.2, U3.10 (AIN6N)
A6P: C43.1, R40.2, U3.9 (AIN6P)
A7N: C47.2, R47.2, U3.11 (AIN7N)
A7P: C47.1, R48.2, U3.12 (AIN7P)
ADCCLK: U3.23 (XTAL1/CLKIN), U$1.27 (GP21)
ADCCS: U3.17 (!CS), U$1.7 (5/SCL0)
ADCRDY: U3.18 (!DRDY), U$1.9 (GP6)
ADCSYNC: U3.16 (!SYNC!/!RESET), U$1.10 (GP7)
AGND: C1.2, C2.2, C3.2, C4.2, C6.2, C7.1, C8.2, C9.1, C11.2, C12.2, C13.2, C14.2, C15.2, C26.2, C27.2, C28.1, C30.2, C31.2, C32.2, C40.1, C41.2, C42.2, C51.2, C52.2, C53.2, C54.2, C55.2, C56.2, C57.2, C58.2, C59.2, C60.2, D1.C, D2.A, GND.1, GND.2, GND.3, GND.4, J2.8, J3.8, J4.8, J5.8, J6.8, J7.8, J8.8, J9.8, J11.2, LP5907.2 (GND), PS1.8 (0V), R5.1, R34.1, U1.3 (GND), U2.1 (GND), U3.13 (AGND_1), U3.28 (AGND_2), U5.14 (GND)
AIN0N: J2.1, R53.1
AIN0P: J2.2, R52.1
AIN1N: J3.1, R50.1
AIN1P: J3.2, R51.1
AIN2N: J4.1, R55.1
AIN2P: J4.2, R54.1
AIN3N: J5.1, R49.1
AIN3P: J5.2, R42.1
AIN4N: J6.1, R44.1
AIN4P: J6.2, R43.1
AIN5N: J7.1, R45.1
AIN5P: J7.2, R46.1
AIN6N: J8.1, R41.1
AIN6P: J8.2, R40.1
AIN7N: J9.1, R47.1
AIN7P: J9.2, R48.1
DAC0: R6.1, U5.4 (VOUTA)
DAC1: R17.1, U5.13 (VOUTB)
DAC2: R21.1, U5.5 (VOUTC)
DAC3: R11.1, U5.12 (VOUTD)
DAC4: R20.1, U5.6 (VOUTE)
DAC5: R13.1, U5.11 (VOUTF)
DAC6: R19.1, U5.7 (VOUTG)
DAC7: R12.1, U5.10 (VOUTH)
DACCS: U5.2 (!SYNC), U$1.11 (GP8)
DACRST: U5.9 (!CLR), U$1.26 (GP20)
EARTH: EARTH-GND.1, J1.P$1, J2.S1 (SHELL), J3.S1 (SHELL), J4.S1 (SHELL), J5.S1 (SHELL), J6.S1 (SHELL), J7.S1 (SHELL), J8.S1 (SHELL), J9.S1 (SHELL)
GND: C5.2, C24.2, C25.2, EARTH-GND.2, PS1.1 (GND), R2.2, R5.2, U3.25 (DGND), U$1.3 (GND8), U$1.8 (GND7), U$1.13 (GND6), U$1.18 (GND5), U$1.23 (GND4), U$1.28 (GND3), U$1.33 (GND2), U$1.38 (GND1), U$1.GND
K0N: J2.4, Q4.3 (C)
K0P: C35.2, J2.3, R33.1
K1N: J3.4, Q2.3 (C)
K1P: C33.2, J3.3, R32.1
K2N: J4.4, Q3.3 (C)
K2P: C34.2, J4.3, R31.1
K3N: J5.4, Q1.3 (C)
K3P: C29.2, J5.3, R24.1
K4N: J6.4, Q5.3 (C)
K4P: C36.2, J6.3, R35.1
K5N: J7.4, Q6.3 (C)
K5P: C38.2, J7.3, R37.1
K6N: J8.4, Q7.3 (C)
K6P: C37.2, J8.3, R38.1
K7N: J9.4, Q8.3 (C)
K7P: C39.2, J9.3, R36.1
LDAC: U5.1 (!LDAC), U$1.12 (GP9)
unnamed: C24.1, U3.24 (CAP)
unnamed: Q7.1 (B), R29.1
unnamed: Q8.1 (B), R27.1
unnamed: Q1.1 (B), R18.1
unnamed: Q6.1 (B), R30.1
unnamed: Q5.1 (B), R28.1
unnamed: Q4.1 (B), R15.1
unnamed: Q2.1 (B), R14.1
unnamed: C11.1, U1.1 (BYPASS)
unnamed: Q3.1 (B), R16.1
unnamed: R6.2, R10.1, U4.2 (-IN)
unnamed: R17.2, R22.1, U4.6 (-IN)
unnamed: R20.2, R26.1, U6.9 (-IN)
unnamed: R9.1, R13.2, U6.2 (-IN)
unnamed: R21.2, R25.1, U4.9 (-IN)
unnamed: R19.2, R23.1, U6.6 (-IN)
unnamed: R8.1, R12.2, U6.13 (-IN)
unnamed: R7.1, R11.2, U4.13 (-IN)
R0: R15.2, U$1.16 (GP12)
R1: R14.2, U$1.17 (GP13)
R2: R16.2, U$1.19 (GP14)
R3: R18.2, U$1.20 (GP15)
R4: R28.2, U$1.21 (16/SPRX)
R5: R30.2, U$1.22 (17/SPCS)
R6: R29.2, U$1.24 (18/SPCK)
R7: R27.2, U$1.25 (19/SPTX)
RGND: C16.2, C17.2, C18.2, C19.2, C20.2, C21.2, C22.2, C23.2, Q1.2 (E), Q2.2 (E), Q3.2 (E), Q4.2 (E), Q5.2 (E), Q6.2 (E), Q7.2 (E), Q8.2 (E), R2.1
SPIOCLK: U3.19 (SCLK), U5.16 (SCLK), U$1.4 (GP2)
SPIORX: U3.20 (DOUT), U$1.6 (4/SDA0)
SPIOTX: U3.21 (DIN), U5.15 (DIN), U$1.5 (GP3)
VIN+: C1.1, C2.1, L1.2, U1.4 (INPUT), U1.8 (!SHUTDOWN)
VIN-: C6.1, C8.1, L2.2, U2.2 (IN), U2.3 (SD*)
VOFF: U4.3 (+IN), U4.5 (+IN), U4.10 (+IN), U4.12 (+IN), U6.3 (+IN), U6.5 (+IN), U6.10 (+IN), U6.12 (+IN), U7.1 (OUT), U7.4 (-IN)
VS0: J2.5, R10.2, U4.1 (OUT)
VS1: J3.5, R22.2, U4.7 (OUT)
VS2: J4.5, R25.2, U4.8 (OUT)
VS3: J5.5, R7.2, U4.14 (OUT)
VS4: J6.5, R26.2, U6.8 (OUT)
VS5: J7.5, R9.2, U6.1 (OUT)
VS6: J8.5, R23.2, U6.7 (OUT)
VS7: J9.5, R8.2, U6.14 (OUT)
VUSB: C5.1, PS1.14 (VIN), R1.2, U$1.40 (VBUS)

Notes on the sheet:
Fixes: - U4 and U6 PS pins were backwards

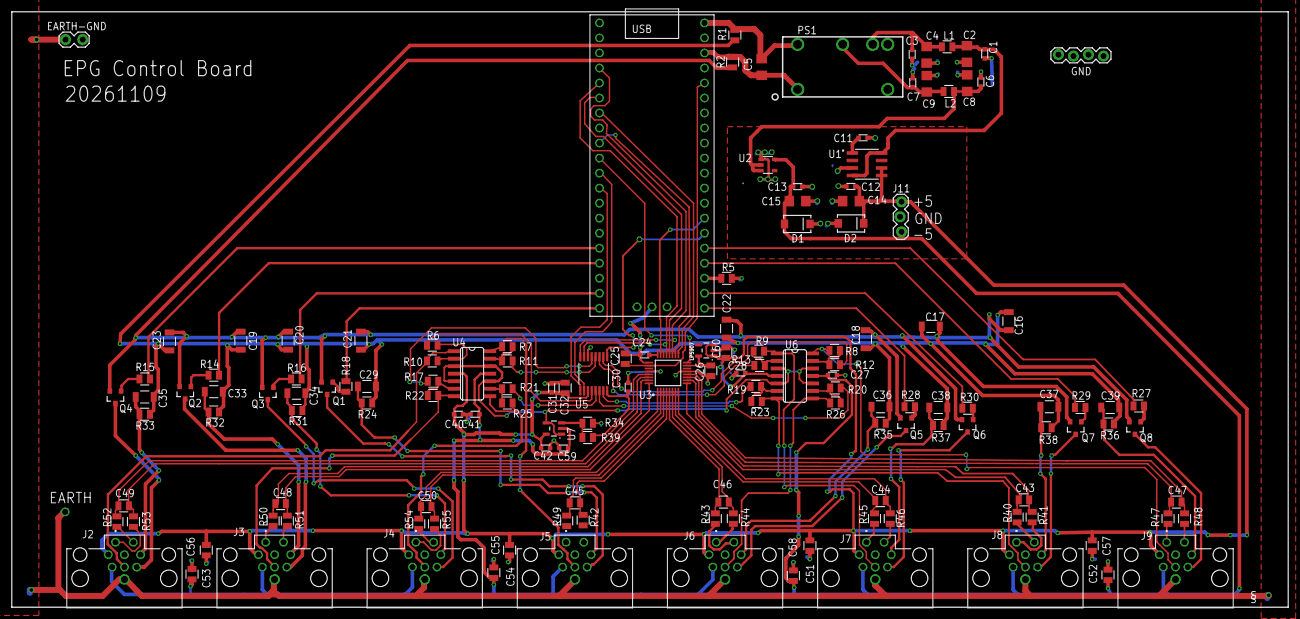
[picture p42: board EPGcontrolA.brd from above]

Board: 2 copper layers, 215.9 x 100.7 mm, 146 parts (0 on the bottom side), 117 nets.
