janelia-experimental-technology/ElectricalPenetrationGraph/hardware/pcb/eagle/EPGinputRelayB.brd

## EAGLE design hardware/pcb/eagle/EPGinputRelayB.brd (2026-11-13)

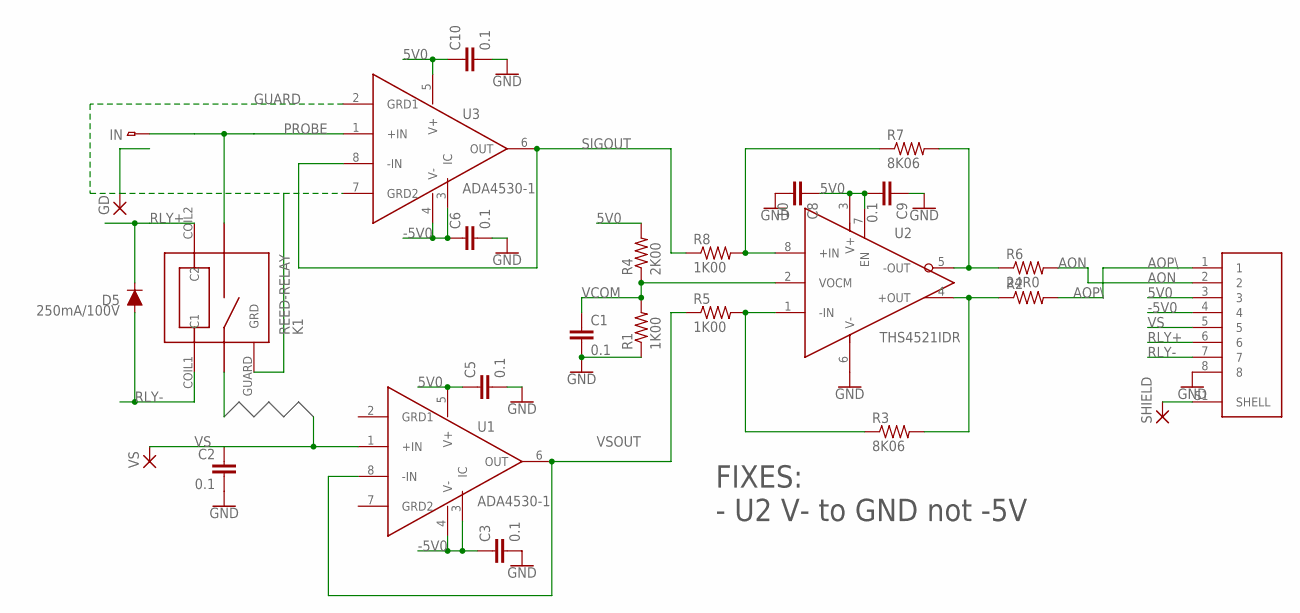
[picture p43: schematic EPGinputRelayB.sch]

Parts:
C1, C2, C3, C5, C6, C9, C10: 0.1; 0603S
C8: 10; 1206S
D5: 250mA/100V; SOD-323
GD: 2,15/1,0
IN: PADPAD150; PAD-150SQ
J1: 54-00251; TENSILITY_54-00248
K1: REED-RELAY; MRE05
R1, R5, R8: 1K00; 0805S
R2: RESISTOR_SM0805S; 0805S
R3, R7: 8K06; 0805S
R4: 2K00; 0805S
R6: 24R0; 0805S
SHIELD: 2,15/1,0
U1, U3: ADA4530-1; SOIC-8
U2: THS4521IDR; SOIC-8
VS: 2,15/1,0

Connections:
5V0: C5.1, C8.1, C9.2, C10.1, J1.3, R4.2, U1.5 (V+), U2.3 (V+), U2.7 (EN), U3.5 (V+)
-5V0: C3.1, C6.1, J1.4, U1.3 (IC), U1.4 (V-), U3.3 (IC), U3.4 (V-)
AON: J1.2, R6.2
AOP\: J1.1, R2.2
GND: C1.2, C2.2, C3.2, C5.2, C6.2, C8.2, C9.1, C10.2, J1.8, R1.1, U2.6 (V-)
GUARD: GD.1, K1.GUARD (GRD), U3.2 (GRD1), U3.7 (GRD2)
unnamed: J1.S1 (SHELL), SHIELD.1
unnamed: R7.1, R8.2, U2.8 (+IN)
unnamed: R3.1, R5.2, U2.1 (-IN)
unnamed: R2.1, R3.2, U2.4 (+OUT)
unnamed: R6.1, R7.2, U2.5 (-OUT)
PROBE: IN.P$1, U3.1 (+IN)
RLY+: D5.C, J1.6, K1.COIL2 (C2)
RLY-: D5.A, J1.7, K1.COIL1 (C1)
SIGOUT: R8.1, U3.6 (OUT), U3.8 (-IN)
VCOM: C1.1, R1.2, R4.1, U2.2 (VOCM)
VS: C2.1, J1.5, U1.1 (+IN), VS.1
VSOUT: R5.1, U1.6 (OUT), U1.8 (-IN)

Notes on the sheet:
FIXES: - U2 V- to GND not -5V

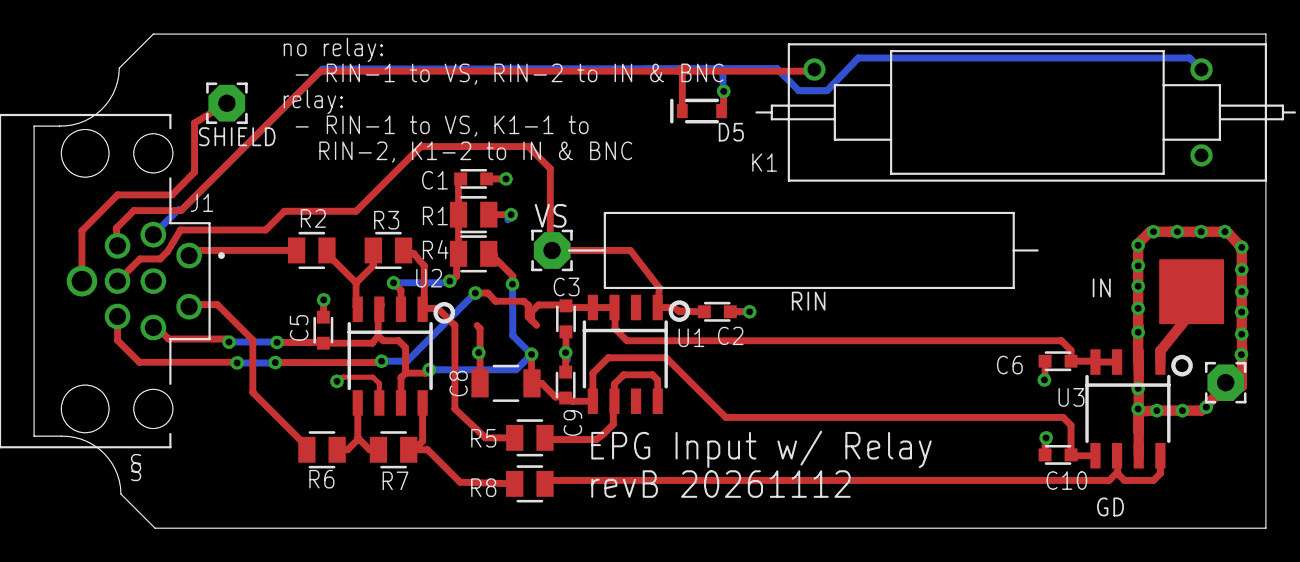
[picture p44: board EPGinputRelayB.brd from above]

Board: 2 copper layers, 72.3 x 29.0 mm, 28 parts (0 on the bottom side), 18 nets.

Other parts of the board:
RIN: 1GRES
U$1: BNC
