janelia-experimental-technology/ElectricalPenetrationGraph/hardware/pcb/eagle/EPGcontrolUniDAC-ClaudeCode-withBuff.brd

## EAGLE design hardware/pcb/eagle/EPGcontrolUniDAC-ClaudeCode-withBuff.brd (2026-11-04)

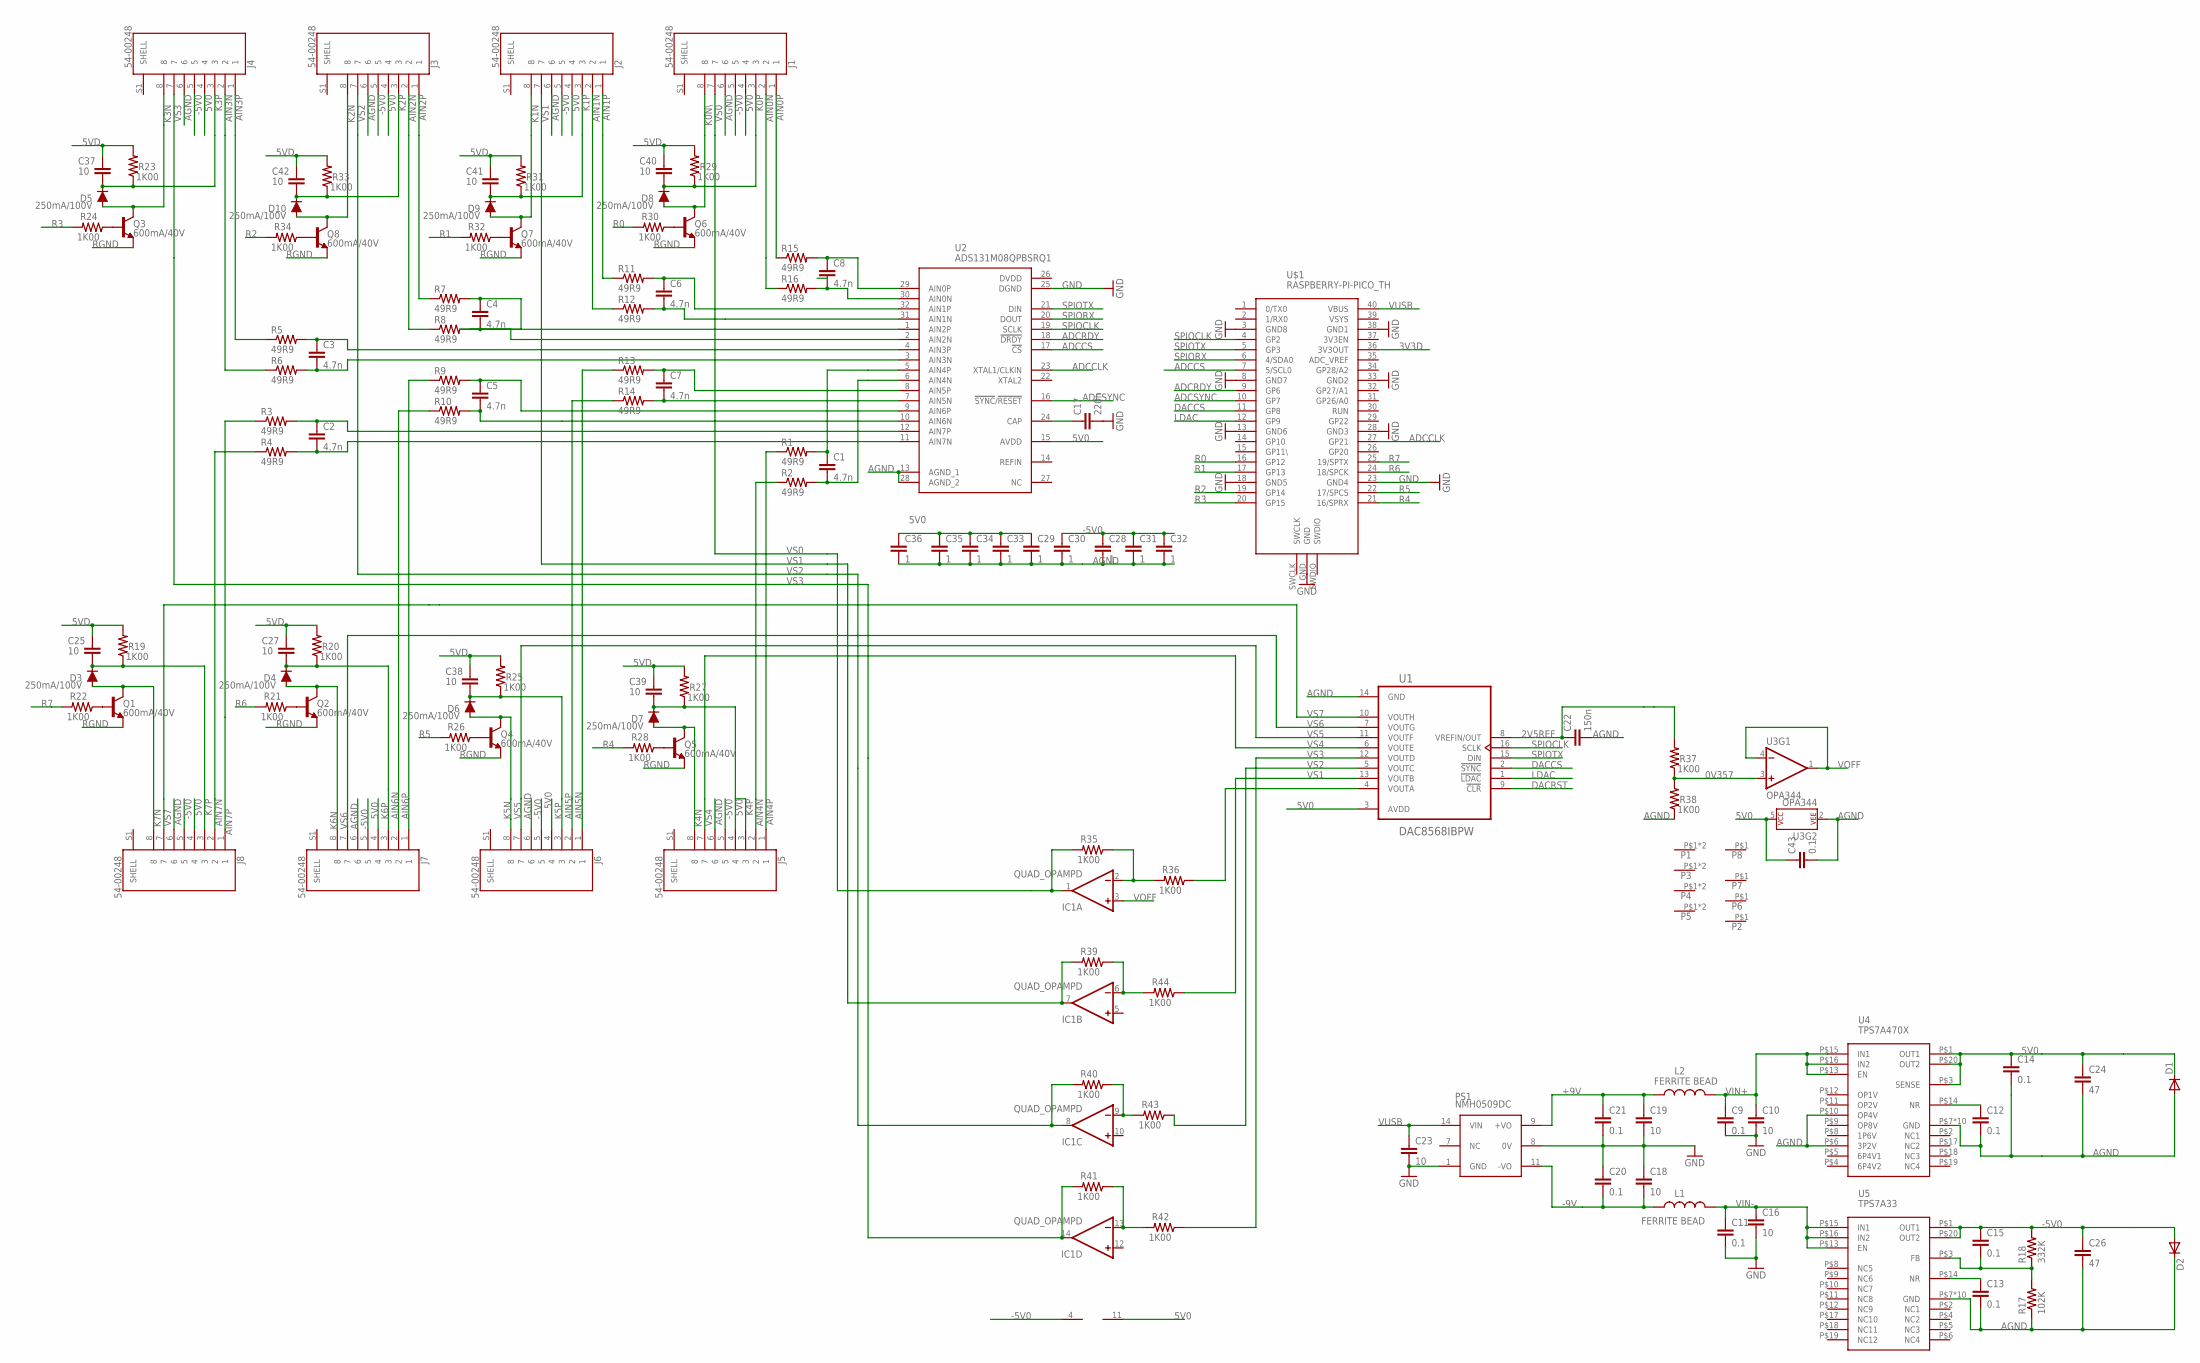
[picture p45: schematic EPGcontrolUniDAC-ClaudeCode-withBuff.sch]

Parts:
C1, C2, C3, C4, C5, C6, C7, C8: 4.7n; 0603S
C9, C11, C12, C13, C14, C15, C20, C21, C43: 0.1; 0603S
C10, C16, C18, C19, C23: 10; C1206
C17: 220n; 0603S
C22: 150n; 0603S
C24, C26: 47; C1206
C25, C27, C37, C38, C39, C40, C41, C42: 10; 1206S
C28, C29, C30, C31, C32, C33, C34, C35, C36: 1; 0805S
D1, D2: DIODESMA; SMA-DIODE
D3, D4, D5, D6, D7, D8, D9, D10: 250mA/100V; SOD-323
IC1: QUAD_OPAMPD; SO14
J1, J2, J3, J4, J5, J6, J7, J8: 54-00248; TENSILITY_54-00248
L1, L2: FERRITE BEAD; 0805S
P1, P3, P4, P5: CON1BANANA; BANANA_105-0754-001
P2, P6, P7, P8: CON1574; 574
PS1: NMH0509DC; PDM2
Q1, Q2, Q3, Q4, Q5, Q6, Q7, Q8: 600mA/40V; SOT23-3
R1, R2, R3, R4, R5, R6, R7, R8, R9, R10, R11, R12, R13, R14, R15, R16: 49R9; 0805S
R17: 102K; R0805
R18: 332K; R0805
R19, R20, R21, R22, R23, R24, R25, R26, R27, R28, R29, R30, R31, R32, R33, R34, R35, R36, R37, R38, R39, R40, R41, R42, R43, R44: 1K00; 0805S
U1: DAC8568IBPW; SOP65P640X120-16N
U2: ADS131M08QPBSRQ1; QFP50P700X700X120-32N
U3: OPA344; SOT23-5
U4: TPS7A470X; VQFN-20-5X5
U5: TPS7A33; VQFN-20-5X5
U$1: RASPBERRY-PI-PICO_TH; FT_RASPBERRY-PI-PICO_TH

Connections:
0V357: R37.1, R38.2, U3.3 (+IN)
2V5REF: C22.1, R37.2, U1.8 (VREFIN/OUT)
3V3D: U$1.36 (3V3OUT)
5V0: C14.1, C24.1, C29.1, C33.1, C34.1, C35.1, C36.1, C43.1, D1.C, IC1.11 (V-), J1.4, J2.4, J3.4, J4.4, J5.4, J6.4, J7.4, J8.4, U1.3 (AVDD), U2.15 (AVDD), U3.5 (P$V+), U4.P$1 (OUT1), U4.P$3 (SENSE), U4.P$20 (OUT2)
5VD: C25.1, C27.1, C37.1, C38.1, C39.1, C40.1, C41.1, C42.1, R19.2, R20.2, R23.2, R25.2, R27.2, R29.2, R31.2, R33.2
+9V: C19.1, C21.1, L2.1, PS1.9 (+VO)
-5V0: C15.1, C26.1, C28.1, C30.1, C31.1, C32.1, D2.A, IC1.4 (V+), J1.5, J2.5, J3.5, J4.5, J5.5, J6.5, J7.5, J8.5, R18.2, U5.P$1 (OUT1), U5.P$20 (OUT2)
-9V: C18.2, C20.2, L1.1, PS1.11 (-VO)
A0N: C8.2, R16.2, U2.30 (AIN0N)
A0P: C8.1, R15.2, U2.29 (AIN0P)
A1N: C6.2, R12.2, U2.31 (AIN1N)
A1P: C6.1, R11.2, U2.32 (AIN1P)
A2N: C4.2, R8.2, U2.2 (AIN2N)
A2P: C4.1, R7.2, U2.1 (AIN2P)
A3N: C3.2, R6.2, U2.3 (AIN3N)
A3P: C3.1, R5.2, U2.4 (AIN3P)
A4N: C1.2, R2.2, U2.6 (AIN4N)
A4P: C1.1, R1.2, U2.5 (AIN4P)
A5N: C7.2, R14.2, U2.7 (AIN5N)
A5P: C7.1, R13.2, U2.8 (AIN5P)
A6N: C5.2, R10.2, U2.10 (AIN6N)
A6P: C5.1, R9.2, U2.9 (AIN6P)
A7N: C2.2, R4.2, U2.11 (AIN7N)
A7P: C2.1, R3.2, U2.12 (AIN7P)
ADCCLK: U2.23 (XTAL1/CLKIN), U$1.27 (GP21)
ADCCS: U2.17 (!CS), U$1.7 (5/SCL0)
ADCRDY: U2.18 (!DRDY), U$1.9 (GP6)
ADCSYNC: U2.16 (!SYNC!/!RESET), U$1.10 (GP7)
AGND: C12.2, C13.2, C14.2, C22.2, C24.2, C26.2, C28.2, C29.2, C30.2, C31.2, C32.2, C33.2, C34.2, C35.2, C36.2, C43.2, D1.A, D2.C, J1.6, J2.6, J3.6, J4.6, J5.6, J6.6, J7.6, J8.6, R17.1, R38.1, U1.14 (GND), U2.13 (AGND_1), U2.28 (AGND_2), U3.2 (P$V-), U4.P$6 (3P2V), U4.P$7 (GND), U4.P$10 (OP4V), U4.PAD1 (GND), U4.PAD2 (GND), U4.PAD3 (GND), U4.PAD4 (GND), U4.PAD5 (GND), U4.PAD6 (GND), U4.PAD7 (GND), U4.PAD8 (GND), U4.PAD9 (GND), U5.P$7 (GND), U5.PAD1 (GND), U5.PAD2 (GND), U5.PAD3 (GND), U5.PAD4 (GND), U5.PAD5 (GND), U5.PAD6 (GND), U5.PAD7 (GND), U5.PAD8 (GND), U5.PAD9 (GND)
AIN0N: J1.2, R16.1
AIN0P: J1.1, R15.1
AIN1N: J2.2, R12.1
AIN1P: J2.1, R11.1
AIN2N: J3.2, R8.1
AIN2P: J3.1, R7.1
AIN3N: J4.2, R6.1
AIN3P: J4.1, R5.1
AIN4N: J5.2, R2.1
AIN4P: J5.1, R1.1
AIN5N: J6.1, R13.1
AIN5P: J6.2, R14.1
AIN6N: J7.2, R10.1
AIN6P: J7.1, R9.1
AIN7N: J8.2, R4.1
AIN7P: J8.1, R3.1
DACCS: U1.2 (!SYNC), U$1.11 (GP8)
DACRST: U1.9 (!CLR)
GND: C9.2, C10.2, C11.2, C16.2, C17.2, C18.1, C19.2, C20.1, C21.2, C23.2, PS1.1 (GND), PS1.8 (0V), U2.25 (DGND), U$1.3 (GND8), U$1.8 (GND7), U$1.13 (GND6), U$1.18 (GND5), U$1.23 (GND4), U$1.28 (GND3), U$1.33 (GND2), U$1.38 (GND1), U$1.GND
K0N\: D8.A, J1.8, Q6.3 (C)
K0P: C40.2, D8.C, J1.3, R29.1
K1N: D9.A, J2.8, Q7.3 (C)
K1P: C41.2, D9.C, J2.3, R31.1
K2N: D10.A, J3.8, Q8.3 (C)
K2P: C42.2, D10.C, J3.3, R33.1
K3N: D5.A, J4.8, Q3.3 (C)
K3P: C37.2, D5.C, J4.3, R23.1
K4N: D7.A, J5.8, Q5.3 (C)
K4P: C39.2, D7.C, J5.3, R27.1
K5N: D6.A, J6.8, Q4.3 (C)
K5P: C38.2, D6.C, J6.3, R25.1
K6N: D4.A, J7.8, Q2.3 (C)
K6P: C27.2, D4.C, J7.3, R20.1
K7N: D3.A, J8.8, Q1.3 (C)
K7P: C25.2, D3.C, J8.3, R19.1
LDAC: U1.1 (!LDAC), U$1.12 (GP9)
unnamed: C15.2, R17.2, R18.1, U5.P$3 (FB)
unnamed: C17.1, U2.24 (CAP)
unnamed: Q2.1 (B), R21.1
unnamed: Q1.1 (B), R22.1
unnamed: Q3.1 (B), R24.1
unnamed: Q4.1 (B), R26.1
unnamed: Q5.1 (B), R28.1
unnamed: Q6.1 (B), R30.1
unnamed: Q7.1 (B), R32.1
unnamed: R36.1, U1.4 (VOUTA)
unnamed: Q8.1 (B), R34.1
unnamed: IC1.2 (-IN), R35.1, R36.2
unnamed: IC1.6 (-IN), R39.1, R44.2
unnamed: R44.1, U1.13 (VOUTB)
unnamed: C13.1, U5.P$14 (NR)
unnamed: R43.1, U1.5 (VOUTC)
unnamed: IC1.9 (-IN), R40.1, R43.2
unnamed: C12.1, U4.P$14 (NR)
unnamed: IC1.13 (-IN), R41.1, R42.2
unnamed: R42.1, U1.12 (VOUTD)
R0: R30.2, U$1.16 (GP12)
R1: R32.2, U$1.17 (GP13)
R2: R34.2, U$1.19 (GP14)
R3: R24.2, U$1.20 (GP15)
R4: R28.2, U$1.21 (16/SPRX)
R5: R26.2, U$1.22 (17/SPCS)
R6: R21.2, U$1.24 (18/SPCK)
R7: R22.2, U$1.25 (19/SPTX)
RGND: Q1.2 (E), Q2.2 (E), Q3.2 (E), Q4.2 (E), Q5.2 (E), Q6.2 (E), Q7.2 (E), Q8.2 (E)
SPIOCLK: U1.16 (SCLK), U2.19 (SCLK), U$1.4 (GP2)
SPIORX: U2.20 (DOUT), U$1.6 (4/SDA0)
SPIOTX: U1.15 (DIN), U2.21 (DIN), U$1.5 (GP3)
VIN+: C9.1, C10.1, L2.2, U4.P$13 (EN), U4.P$15 (IN1), U4.P$16 (IN2)
VIN-: C11.1, C16.1, L1.2, U5.P$13 (EN), U5.P$15 (IN1), U5.P$16 (IN2)
VOFF: IC1.3 (+IN), U3.1 (OUT), U3.4 (-IN)
VS0: IC1.1 (OUT), J1.7, R35.2
VS1: IC1.7 (OUT), J2.7, R39.2
VS2: IC1.8 (OUT), J3.7, R40.2
VS3: IC1.14 (OUT), J4.7, R41.2
VS4: J5.7, U1.6 (VOUTE)
VS5: J6.7, U1.11 (VOUTF)
VS6: J7.7, U1.7 (VOUTG)
VS7: J8.7, U1.10 (VOUTH)
VUSB: C23.1, PS1.14 (VIN), U$1.40 (VBUS)

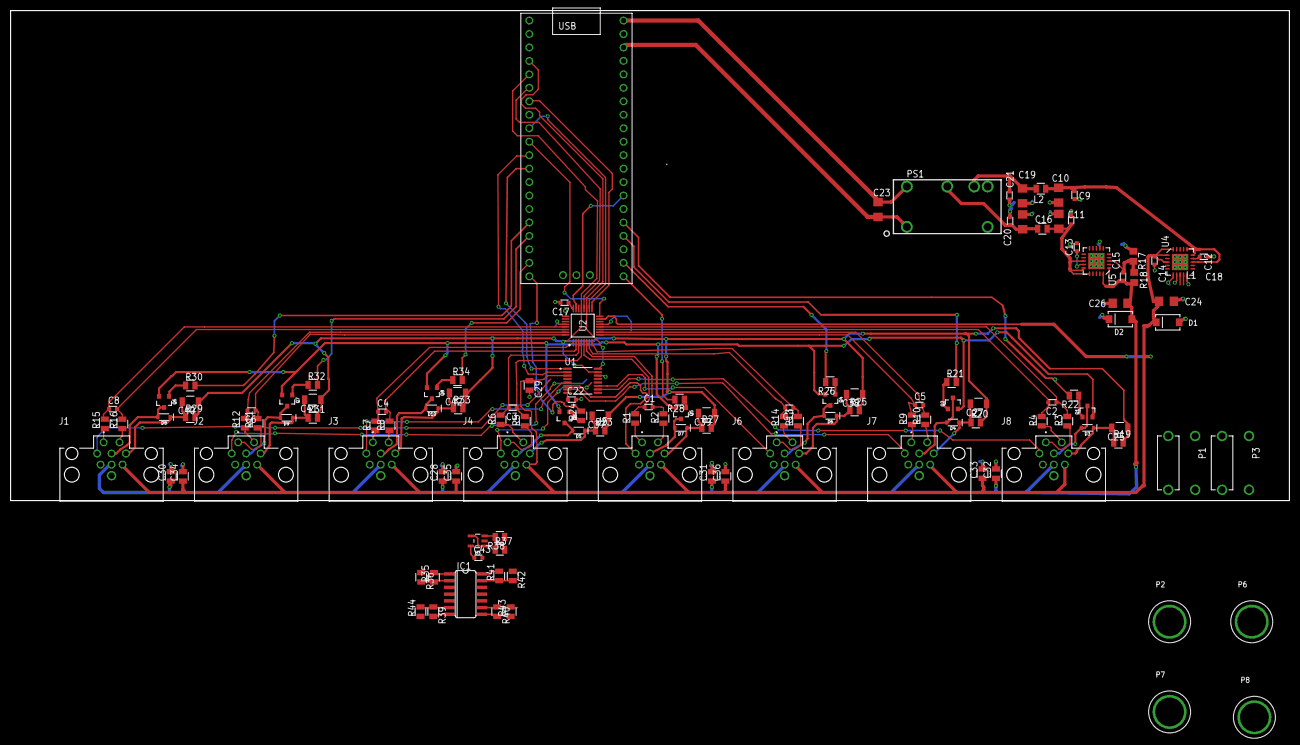
[picture p46: board EPGcontrolUniDAC-ClaudeCode-withBuff.brd from above]

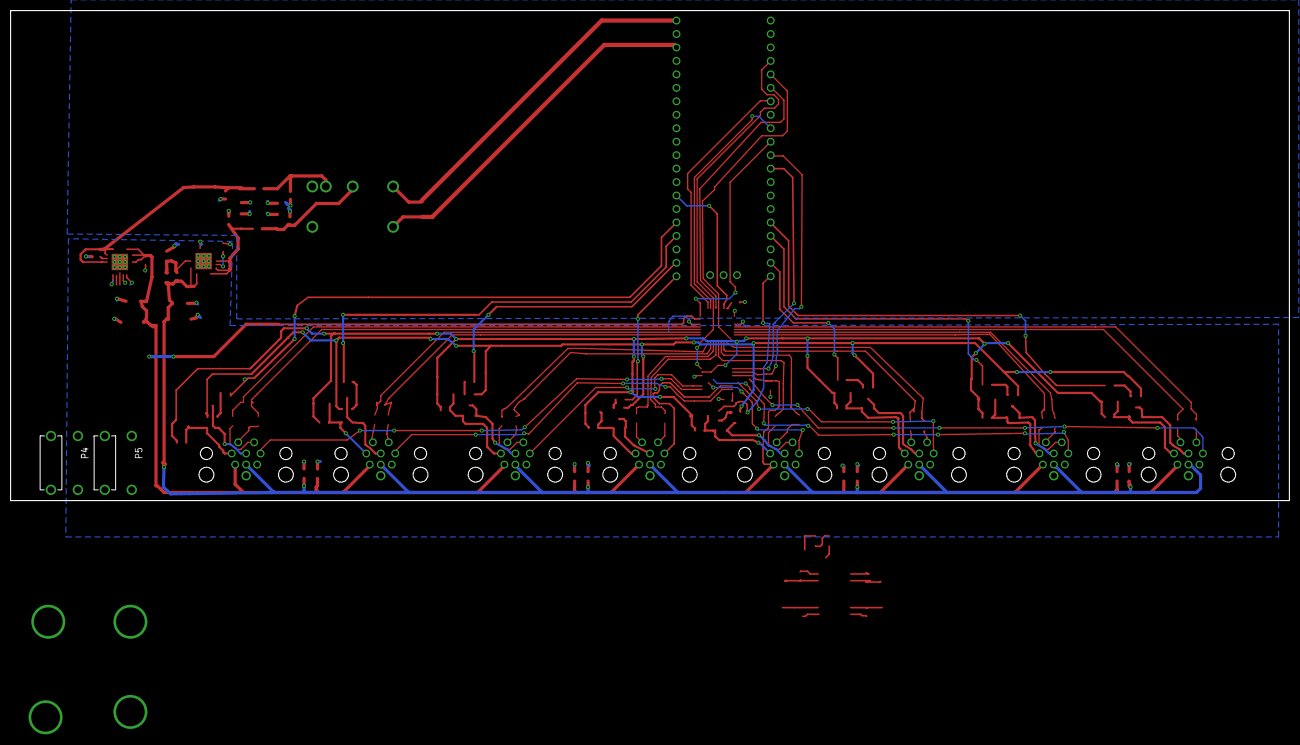
[picture p47: board EPGcontrolUniDAC-ClaudeCode-withBuff.brd from below]

Board: 2 copper layers, 241.3 x 92.5 mm, 131 parts (2 on the bottom side), 107 nets.
