janelia-experimental-technology/ElectricalPenetrationGraph/hardware/pcb/eagle/powerSupply.brd

## EAGLE design hardware/pcb/eagle/powerSupply.brd (2026-10-26)

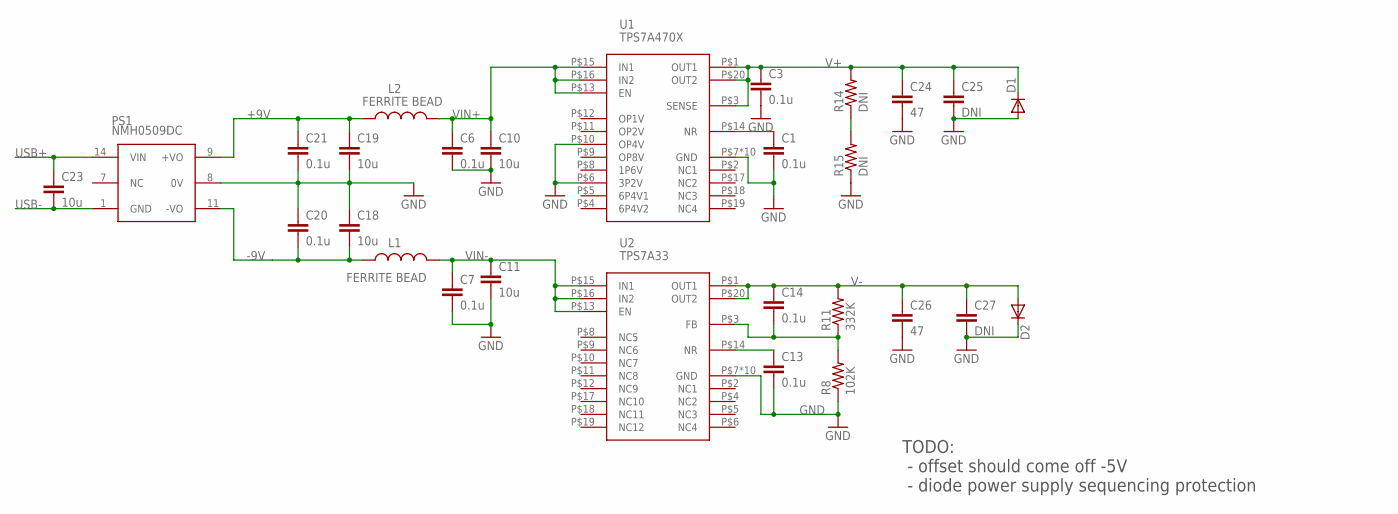
[picture p48: schematic powerSupply.sch]

Parts:
C1, C3, C6, C7, C13, C14, C20, C21: 0.1u; 0603S
C10, C11, C18, C19, C23: 10u; C1206
C24, C26: 47; C1206
C25, C27: DNI; C1206
D1, D2: DIODESMA; SMA-DIODE
L1, L2: FERRITE BEAD; 0805S
PS1: NMH0509DC; PDM2
R8: 102K; R0805
R11: 332K; R0805
R14, R15: DNI; R0805
U1: TPS7A470X; VQFN-20-5X5
U2: TPS7A33; VQFN-20-5X5

Connections:
+9V: C19.1, C21.1, L2.1, PS1.9 (+VO)
-9V: C18.2, C20.2, L1.1, PS1.11 (-VO)
GND: C1.2, C3.2, C6.2, C7.2, C10.2, C11.2, C13.2, C18.1, C19.2, C20.1, C21.2, C24.2, C25.2, C26.2, C27.2, D1.A, D2.C, PS1.8 (0V), R8.1, R15.1, U1.P$6 (3P2V), U1.P$7 (GND), U1.P$10 (OP4V), U1.PAD1 (GND), U1.PAD2 (GND), U1.PAD3 (GND), U1.PAD4 (GND), U1.PAD5 (GND), U1.PAD6 (GND), U1.PAD7 (GND), U1.PAD8 (GND), U1.PAD9 (GND), U2.P$7 (GND), U2.PAD1 (GND), U2.PAD2 (GND), U2.PAD3 (GND), U2.PAD4 (GND), U2.PAD5 (GND), U2.PAD6 (GND), U2.PAD7 (GND), U2.PAD8 (GND), U2.PAD9 (GND)
unnamed: C14.2, R8.2, R11.1, U2.P$3 (FB)
unnamed: R14.1, R15.2
unnamed: C13.1, U2.P$14 (NR)
unnamed: C1.1, U1.P$14 (NR)
USB+: C23.1, PS1.14 (VIN)
USB-: C23.2, PS1.1 (GND)
V+: C3.1, C24.1, C25.1, D1.C, R14.2, U1.P$1 (OUT1), U1.P$3 (SENSE), U1.P$20 (OUT2)
V-: C14.1, C26.1, C27.1, D2.A, R11.2, U2.P$1 (OUT1), U2.P$20 (OUT2)
VIN+: C6.1, C10.1, L2.2, U1.P$13 (EN), U1.P$15 (IN1), U1.P$16 (IN2)
VIN-: C7.1, C11.1, L1.2, U2.P$13 (EN), U2.P$15 (IN1), U2.P$16 (IN2)

Notes on the sheet:
TODO: - offset should come off -5V - diode power supply sequencing protection

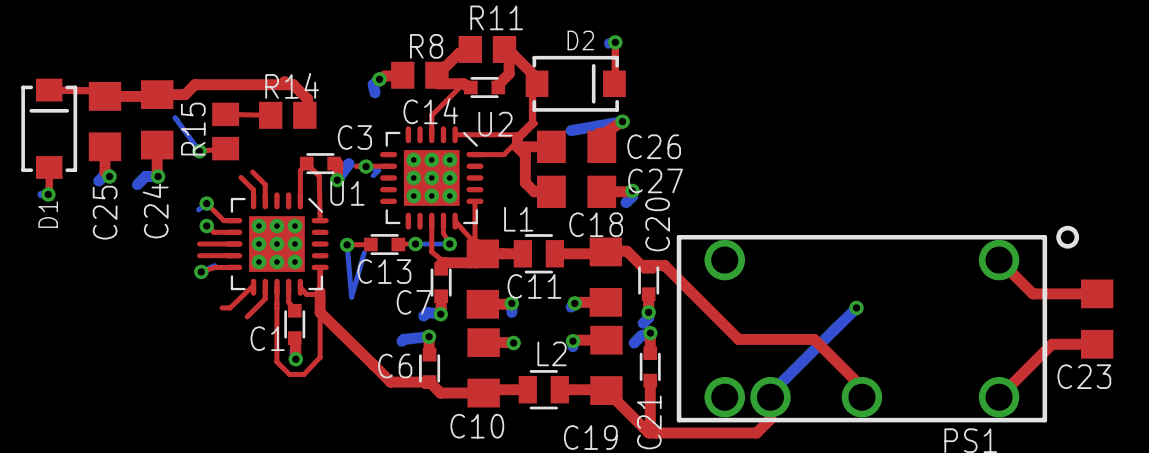
[picture p49: board powerSupply.brd from above]

Board: 2 copper layers, 28 parts (0 on the bottom side), 13 nets.
