janelia-experimental-technology/ElectricalPenetrationGraph/hardware/pcb/eagle/EPGinput.brd

## EAGLE design hardware/pcb/eagle/EPGinput.brd (2026-10-22)

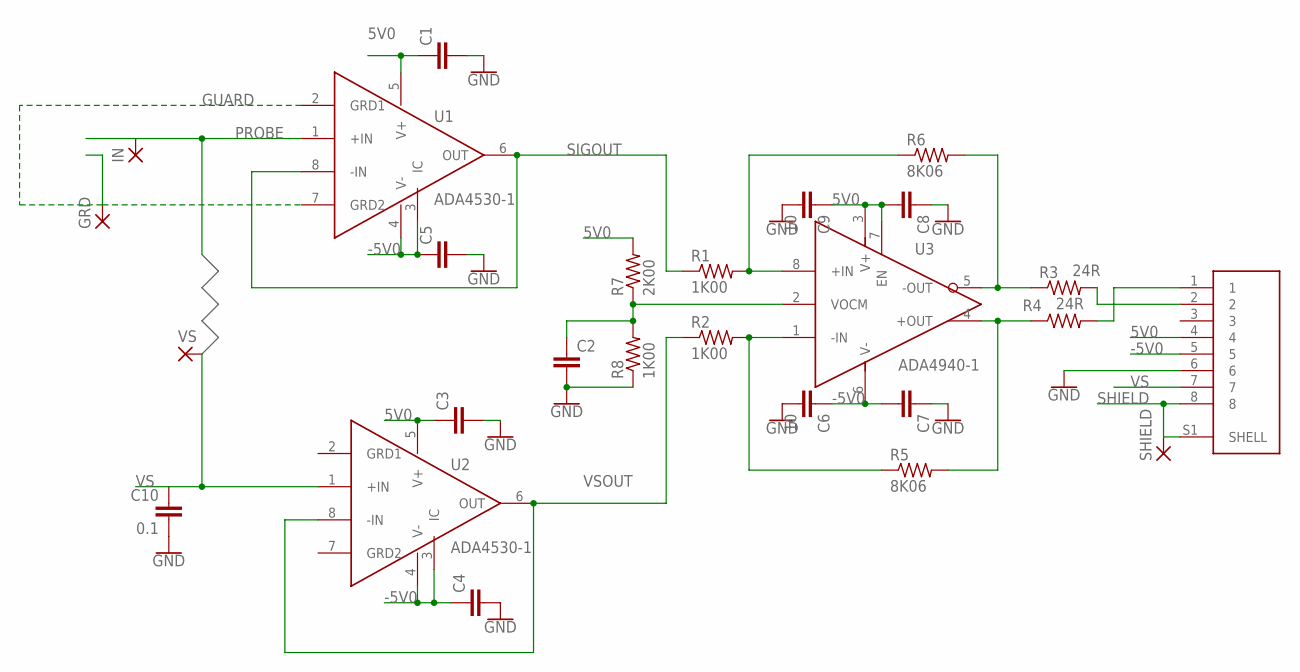
[picture p50: schematic EPGinput.sch]

Parts:
C1, C2, C3, C4, C5, C7, C8: CAPS0603S; 0603S
C6, C9: 10; 1206S
C10: 0.1; 0603S
GRD: 2,15/1,0
IN: SMD2; SMD1,27-2,54
J1: 54-00248; TENSILITY_54-00248
R1, R2, R8: 1K00; 0805S
R3, R4: 24R; 0805S
R5, R6: 8K06; 0805S
R7: 2K00; 0805S
SHIELD: 2,15/1,0
U1, U2: ADA4530-1; SOIC-8
U3: ADA4940-1; SOIC-8
VS: 2,15/1,0

Connections:
5V0: C1.1, C3.1, C8.2, C9.1, J1.4, R7.2, U1.5 (V+), U2.5 (V+), U3.3 (V+), U3.7 (EN)
-5V0: C4.1, C5.1, C6.1, C7.2, J1.5, U1.3 (IC), U1.4 (V-), U2.3 (IC), U2.4 (V-), U3.6 (V-)
GND: C1.2, C2.2, C3.2, C4.2, C5.2, C6.2, C7.1, C8.1, C9.2, C10.2, J1.6, R8.1
GUARD: GRD.1, U1.2 (GRD1), U1.7 (GRD2)
unnamed: C2.1, R7.1, R8.2, U3.2 (VOCM)
unnamed: R1.2, R6.1, U3.8 (+IN)
unnamed: R2.2, R5.1, U3.1 (-IN)
unnamed: J1.2, R3.2
unnamed: J1.1, R4.2
unnamed: R4.1, R5.2, U3.4 (+OUT)
unnamed: R3.1, R6.2, U3.5 (-OUT)
PROBE: IN.1, U1.1 (+IN)
SHIELD: J1.8, J1.S1 (SHELL), SHIELD.1
SIGOUT: R1.1, U1.6 (OUT), U1.8 (-IN)
VS: C10.1, J1.7, U2.1 (+IN), VS.1
VSOUT: R2.1, U2.6 (OUT), U2.8 (-IN)

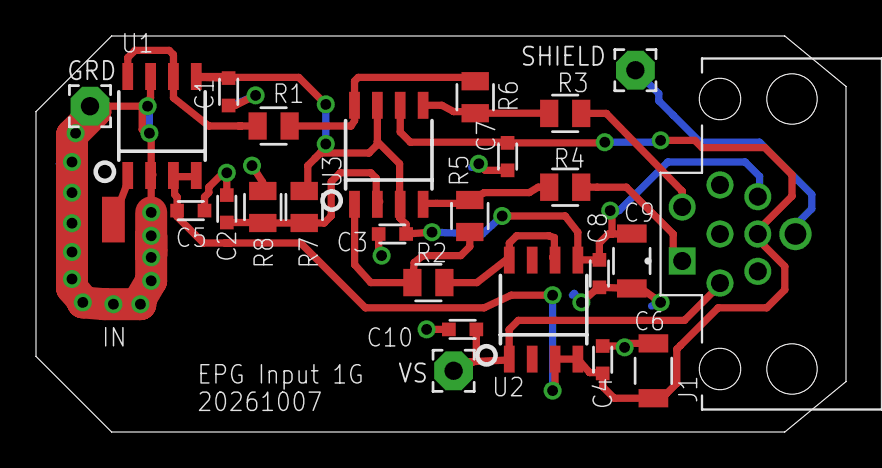
[picture p51: board EPGinput.brd from above]

Board: 2 copper layers, 45.0 x 22.0 mm, 27 parts (0 on the bottom side), 16 nets.

Other parts of the board:
U$1: POMONA2397
