janelia-experimental-technology/ElectricalPenetrationGraph/(commit log)

2026-07-01 add kicad file
2026-09-17 add sch files
    [.kicad_sch.kicad_sch, single_channel_manual.kicad_sch]
2026-09-21 start 1G design
    [.kicad_sch, single_channel_1G.kicad_pcb, single_channel_1G.kicad_sch, single_channel_manual-1G.kicad_sch, single_channel_manual.kicad_pcb]
2026-09-29 eagle schematic/pcb
    [EPGinput.brd, EPGinput.sch]
2026-09-30 Eagle PCB updates
    [54-00248(2).STEP, BJ21.iam, BJ21.stp, BJ21_PART1.ipt, BJ21_PART2.ipt, BJ21_PART3.ipt, EPGinput.brd, EPGinput.sch]
2026-10-07 board out
    [EPGinput.brd, EPGinput.sch, epgIn.0004.iam, epgIn.iam, pcb.0002.ipt, pcb.ipt, pomona_2397_box_no_cover.0001.ipt, pomona_2397_box_no_cover.ipt]
2026-10-07 db board
    [EPGinputDB.brd, EPGinputDB.sch]
2026-10-17 PCB and mech models
2026-10-17 PCB w/ relay
2026-10-22 started control board
2026-10-26 Control Board updates
2026-10-28 EPGcontrol PCB updates - relay
2026-11-03 new controller boards
2026-11-05 redo wiring
2026-11-09 fixes to boards
2026-11-13 board updates
