janelia-experimental-technology/ElectricalPenetrationGraph/(notices)

Notices in the files:
hardware/pcb/eagle/BJ21.stp:
author */ ('License CC BY-ND 4.0'),
parts and their libraries:
SparkFun-PowerSymbols: Licensing: Creative Commons ShareAlike 4.0 International - https://creativecommons.org/licenses/by-sa/4.0
STEVES_BU: COPYRIGHT: Copyright (C) 2026 Ultra Librarian. All rights reserved.
